MediBrick/IMU_Brick/v2/KiCAD/reports/mask-paste-audit-2026-09-21.md

# Activity Brick V2 mask and paste audit — 2026-09-21

This review compared the **saved PCB**, its placed footprints, and the project footprint library with the local manufacturer datasheets and integration manuals. The NCV8705 row was refreshed after its thermal holes were moved outside the footprint. It checks the CAD apertures, not a fabricated stencil. The assembler has not yet accepted the stencil adjustments.

| Device | Saved mask/paste construction | Review |
| --- | --- | --- |
| BMI323 U7 | All 14 pads have individual front-mask and front-paste apertures at the copper pad locations; no vias intersect the pads. | Consistent with the Bosch LGA land pattern in [BMI323](../../datasheets/BMI323.pdf). Confirm final stencil release and placement height with assembler. |
| BMM350 U5 | Nine 0.25 mm copper lands on 0.40 mm pitch; each mask opening is 0.30 mm from 0.025 mm radial expansion, leaving a nominal 0.10 mm mask web. Paste is 0.25 mm per land. No via intersects a land. | **NSMD confirmed**: mask opening is larger than copper. Bosch [BMM350](../../datasheets/BMM350.pdf) describes NSMD and points to its HSMI landing pattern. Fabricator/assembler must confirm that the 0.10 mm mask webs and nine small stencil apertures are achievable at yield. |
| BMP581 U6 | Ten individual copper, mask, and paste lands; no pad-intersecting vias. | The Bosch [BMP581](../../datasheets/bst_bmp581_ds004-2950309.pdf) soldering section requires at least 25 µm reflowed stand-off and warns against excess paste. The final stencil/process must be checked for that stand-off; the CAD alone cannot establish it. |
| TPS63802 U1 | Ten copper/mask lands. Pad 8 deliberately has **no pad-level paste**; two separate 0.55 × 0.25 mm front-paste shapes cover it. Other nine pads have paste. No pad-intersecting vias. | This matches the reduced pad-8, approximately 83% coverage example in the [TI TPS63802](../../datasheets/TPS63802.pdf) DLA0010A stencil drawing (PDF page 37, for a 0.10 mm stencil). The two paste shapes are present in both the library and saved PCB; a pad-only query would miss them. |
| NCV8705 U2 | Custom front-mask polygons expose the six perimeter pads and the solid 1.0 × 1.6 mm center pad 7. Six perimeter paste apertures are 0.46 × 0.31 mm; two center paste windows are 1.01 × 0.71 mm each. Pad 7 is now SMD copper only, with no holes. Two separate GND vias on the board at (166.40, 76.70) and (166.30, 79.85) mm lie outside the footprint's mask and paste openings. Each is 0.30 mm drill / 0.60 mm copper diameter. | **Via-in-pad issue resolved in CAD.** The external via rings are nominally 0.15 mm, and neither hole can wick solder from the exposed-pad paste windows. Confirm the final pad-7 GND copper connection and assembler's stencil acceptance. The [onsemi NCV8705](../../datasheets/NCV8705.pdf) package land pattern remains the package reference. |
| USBLC6-2SC6 D8 | Six individual SOT-23-6 copper/mask/paste lands; no pad-intersecting vias. | Conventional leaded SOT-23-6 apertures align with the [ST package drawing](../../datasheets/DS_usblc6-2.pdf). |
| MAX-M10S IC1 | Eighteen 0.7/0.8 × 1.8 mm copper lands use matching mask and full-size paste apertures; no pad-intersecting vias. | **Stencil adaptation remains open.** The [MAX-M10S integration manual](../../datasheets/MAX-M10S_IntegrationManual_UBX-20053088.pdf), §4.4.1, recommends a T-shaped paste pattern that shifts paste outward to wet the module's half-vias, and a 150 µm stencil. The current full-size rectangles do not implement that example. Its exact stencil is process-dependent; obtain assembler approval or revise the paste footprint before release. |
| ZED-F9P IC2 | All 54 perimeter pads and 48 central GND lands have individual copper/mask/paste apertures. Perimeter pads are 0.8 × 1.5 mm; central lands are 1.1 × 1.1 mm. No via intersects a land. | The [ZED-F9P integration manual](../../datasheets/ZED-F9P_IntegrationManual_UBX-18010802.pdf), §4.7.3, provides distinct copper and paste dimensions and says the final paste volume is process-dependent. The current 1:1 paste rectangles do not reproduce all suggested paste dimensions. Obtain assembler approval or tune the paste footprint; ensure all 48 central GND lands solder reliably without excess lift or voids. |

**Release status:** CAD aperture review complete. The NCV8705 via-in-pad concern is closed by the external-via layout. The checklist item remains open pending (1) fabricator/assembler acceptance of the BMM350 0.10 mm mask web and (2) approved MAX and ZED module stencil patterns and BMP581 stand-off. A physical stencil review, solder-paste inspection, and first-article inspection are appropriate for hidden NCV8705 and ZED joints.

## PCBWay capability comparison (checked 2026-09-21)

PCBWay's [standard capability table](https://www.pcbway.com/capabilities.html) lists 0.10 mm minimum trace/space, 0.15 mm minimum annular ring for a via pad, and a 4 mil (0.1016 mm) standard green solder-mask bridge for copper below 2 oz. The BMM350 custom rule is 0.15 mm trace width and 0.15 mm copper clearance; these copper features fit the published standard trace/space limits. Its 0.10 mm nominal mask web is just below the 4 mil bridge figure. Its 0.15 mm copper gap between adjacent 0.25 mm lands is also below the 0.20 mm IC pad spacing that PCBWay's [mask-bridge help](https://www.pcbway.com/helpcenter/soldermask_issues/Soldermask_bridge.html) says is needed to retain a green mask bridge. The [advanced table](https://www.pcbway.com/advanced-pcb-capabilities.html) lists a 3 mil minimum mask bridge, but does not by itself guarantee nine separate openings on this exact 0.40 mm BGA pitch. Request PCBWay's CAM acceptance of the actual Gerbers, explicitly requiring separate NSMD openings or an approved alternate; do not assume the Advanced PCB selector alone resolves it.

The revised NCV8705 layout uses ordinary GND vias outside the component footprint and solder apertures. Their 0.30 mm drills and 0.60 mm copper diameters give 0.15 mm nominal annular rings, matching PCBWay's published standard minimum. The two previous plated holes within pad 7 are absent from both the saved board footprint and the project library. No [PCBWay via-in-pad](https://www.pcbway.com/pcb_prototype/PCB_Via_in_Pad.html) fill/cap process is needed for these two external vias. This conclusion assumes the final GND copper connection survives zone refill and DRC, and does not replace first-article solder-joint inspection.

## Validation after the NCV8705 layout change

KiCad ERC on the saved schematic reports 0 active errors and 13 previously reviewed pin-type warnings. A later RF review removed the 0.0707 mm dangling `GNSS_RF_ZED` track at (129.55, 120.85) mm. KiCad DRC after that edit, with a temporary zone refill, reports **0 active violations, 0 unconnected pads and 0 footprint errors**. The all-severities DRC before the edit displayed the previously excluded C13 starved-thermal error; its exclusion has not been re-adjudicated. The NCV8705 external vias generate no active DRC violations. The temporary refill was not saved to the PCB; final fabrication-output review remains due.
