MediBrick/IMU_Brick/v2/KiCAD/reports/passive-rating-audit-2026-09-21.md

# Activity Brick V2 passive and voltage-rating audit — 2026-09-21

The selected ordering codes come from the Engineering BOM in `Activity_Brick_Production_BOM.xlsx`; the operating rails and component connections were checked against the saved PCB and `Activity Brick V2 Design.md`. MAX and ZED parts are mutually exclusive. This is a specification review, not a hot/cold operating test or short-circuit test.

## Capacitors and DC bias

| References and selected part | Maximum intended DC bias | Nominal / voltage / dielectric | Finding |
| --- | ---: | --- | --- |
| C1, Murata `GRM188R60J106ME47D` | `V_BAT` 4.2 V | 10 µF, 6.3 V, X5R, 0603 | Rated voltage passes. **Effective capacitance open:** TI [TPS63802](../../datasheets/TPS63802.pdf) §8.3 needs at least 4 µF effective at VIN; nominal 10 µF is insufficient proof after ±20% tolerance, DC bias, temperature and aging. C2 is an additional 1 µF on VIN but also derates. Obtain Murata part-specific C–DC-bias curves at 4.2 V and verify the combined minimum. |
| C4/C17, Murata `GRM188R61A226ME15D` | `3V8` ≈3.8 V | 2 × 22 µF, 10 V, X5R, 0603 | Rated voltage passes. TI specifies at least 7 µF **effective** on VOUT above 2.3 V and recommends 2 × 22 µF nominal above 3.6 V. The BOM uses that nominal arrangement, but part-specific capacitance at 3.8 V is not yet recorded. Verify combined minimum with tolerance/temperature/aging. |
| C18/C19, Murata `GRM188R61A106ME69D` | 3.3 / 3.8 V | 10 µF, 10 V, X5R, 0603 | Rated voltage passes. Verify effective capacitance for NCV8705 input/output transient behavior; nominal value alone is not a guaranteed value at bias. |
| C25, Murata `GRM155R61C225KE44D` | `V_BACKUP` 3.0 V | 2.2 µF, 16 V, X5R, 0402 | Rated voltage passes. A 2.2 µF nominal value in 0402 may lose substantial capacitance at 3 V; the BOM requirement states 2 µF. Verify the actual effective value against the ZED backup-supply requirement, or choose a larger-case qualified part. |
| C12, Samsung `CL21B225KOFNNNE` | BMM350 CRST domain, at most sensor core supply | 2.2 µF, 16 V, X7R, 0805 | The [Samsung exact-part page](https://product.samsungsem.com/mlcc/CL21B225KOFNNN.do) confirms the nominal specifications and offers a DC-bias graph, but no numerical minimum has been recorded. This is the accepted replacement for the obsolete Bosch-recommended TDK part. Samsung does **not** certify it as nonmagnetic; installed-board magnetic-offset validation remains necessary. |
| Other 0.1/1 µF Murata bypass capacitors | ≤3.8 V, except C21 on USB VBUS | 16 V, X5R/X7R, 0402 | Voltage rating passes. C21 on USB VBUS also has a 16 V rating; its effective 1 µF at the highest normal USB voltage should be checked against the AP2112 input-capacitor requirement. |

[Murata SimSurfing](https://ds.murata.com/simsurfing/mlcc.html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) provides part-specific C–DC-bias data. X5R/X7R is a temperature classification, not a DC-bias guarantee. Do not treat the nominal rating or a generic 50% derating rule as measured proof for these exact codes.

## Resistors and inductors

| Parts | Rating comparison | Finding |
| --- | --- | --- |
| MAX R40, Vishay `CRCW121010R0FKEAHP` | [Vishay CRCW-HP](https://www.vishay.com/docs/20115/crcwhp.pdf): 10 Ω, 0.75 W at 70 °C. At the MAX-M10S [absolute-maximum](../../datasheets/MAX-M10S.pdf) VCC_RF source current of 250 mA, `I²R = 0.625 W`; at the 50 mA operating allowance, 0.025 W. | Ordinary load is comfortable. The 250 mA number is an absolute-maximum stress rating, **not a guaranteed short-circuit current limit**. The formerly stated 1 W BOM engineering requirement is not met by this selected resistor. Keep the fault-case validation open; confirm short behavior or choose a higher-power geometry. |
| ZED R32, Bourns `CMP2010-FX-10R0ELF` | [Bourns CMP](../../datasheets/Bourns_CMP.pdf): 10 Ω, 1 W at 70 °C. At the ZED-F9P [absolute-maximum](../../datasheets/ZED-F9P.pdf) VCC_RF current of 300 mA, `I²R = 0.90 W`; at 50 mA, 0.025 W. | Meets its 1 W nominal requirement at ≤70 °C for a 300 mA case, subject to derating. A hypothetical ideal 3.3 V source shorted through 10 Ω would dissipate 1.09 W, so the real short-current/thermal behavior still needs validation. |
| Other populated 0402 resistors | BOM lists 0.063 W ratings. The 5.1 kΩ USB CC resistors dissipate about 5.4 mW each at 5.25 V; 100 kΩ pull resistors <0.2 mW at 4.2 V; 1 kΩ LED resistors <11 mW even with 3.3 V entirely across them. Low-value series resistors depend on signal/load current, not the full rail voltage. | No ordinary operating-power conflict identified. Verify manufacturer working-voltage and surge ratings if a specific resistor can see an external transient or fault. |
| L1, Coilcraft `XFL4015-471MEC` | [Coilcraft exact part](https://www.coilcraft.com/en-us/products/power/high-voltage-inductors/xfl/xfl4015/xfl4015-471/): 0.47 µH, 8.36 mΩ max DCR, 3.5 A at 10% inductance drop, 5.4 A at 20% drop, 9.1 A for 20 °C rise. TI lists this same inductor as a [TPS63802](../../datasheets/TPS63802.pdf) reference choice. | Pass for intended GNSS load. At 3.0 V minimum battery, 3.8 V output and 0.18 A output load, TI's boost equation gives roughly 0.5–0.6 A peak, well below its 10%-drop rating. Recalculate if the actual coincident load or minimum battery voltage changes. |
| MAX L2 `LQG15HN27NH02D`; ZED L3 `LQG15HS47NJ02D` | [Murata L2](https://www.murata.com/products/productdetail?partno=LQG15HN27NH02%23): 27 nH ±3%, 300 mA, 0.67 Ω max DCR. [Murata L3](https://www.murata.com/en-us/products/productdetail?partno=LQG15HS47NJ02D): 47 nH ±5%, 300 mA, 0.72 Ω max DCR. | Both pass the 50 mA normal active-antenna allowance. The 300 mA rating is only just equal to the ZED's absolute-maximum VCC_RF source current, so antenna-short survival is an electrical fault test, not a demonstrated continuous operating condition. |

## Maximum intended voltage and magnetometer materials

The stated battery range is 3.0–4.2 V. TPS63802 accepts 1.3–5.5 V, MCP1700 accepts 2.3–6.0 V, and NCV8705 sees regulated ≈3.8 V against a 5.5 V operating maximum; these ratings cover the intended battery and regulator rails. For ordinary USB 5 V operation, use **5.25 V** as the upper check point: [ST USBLC6-2](../../datasheets/DS_usblc6-2.pdf) specifies leakage at VBUS = 5.25 V and VBUS breakdown ≥6 V; [AP2112](../../datasheets/AP2112.pdf) allows VIN to 6.0 V in operation and has a 6.5 V absolute maximum. The USB-input C21 is 16 V. This does not validate arbitrary USB overvoltage, surge, or a noncompliant supply; the ESD device is not a sustained overvoltage disconnect.

The BMM350 vicinity contains C12, C13, C14 and nearby power/routing structures. C12's Samsung part is an already accepted **nonmagnetic-certification exception** in the design document. Neither this BOM nor the local datasheets certify the complete nearby assembly as nonmagnetic. The practical acceptance test is powered, assembled-board hard-/soft-iron calibration and comparison across the MAX and ZED population variants; retain this as a prototype validation requirement rather than claiming a material qualification.

**Checklist disposition:** Keep the combined passive-rating item open until exact-part DC-bias minima are recorded for C1/C2, C4/C17, C18/C19, C21 and C25, and the MAX/ZED antenna-short resistor and choke cases are validated or explicitly accepted with a justified fault duration/thermal limit. The selected inductor and ordinary voltage ratings pass the paper review; C12's magnetic-material exception requires installed-board validation.
