MediBrick/IMU_Brick/v2/KiCAD/reports/pin-pad-audit-2026-09-21.md

# Activity Brick V2 pin and pad audit — 2026-09-21

Scope: the saved schematic, saved PCB, and every project-local symbol and footprint used by them. Manufacturer pin tables and package/land-pattern drawings were compared directly; the 3D models were not used as pinout evidence. This is a CAD verification, not a physical assembly inspection.

The KiCad XML netlist was compared with PCB pad numbers for every used custom symbol. Every numbered schematic pin has a corresponding numbered PCB pad. All 17 used instances of project-local footprints have the same pad numbers, locations, sizes, and drills as their library masters. The manufacturer comparisons are below. `datasheets/` paths are relative to the project root.

| References / exact part | Manufacturer source | Pin, pad, and orientation result |
| --- | --- | --- |
| U7 BMI323 | [Bosch BMI323](../../datasheets/BMI323.pdf), pin configuration and package drawing | Pass. Pin 1 is SDO; pins 2, 3, 10, and 11 are NC. The footprint's pin-1 corner and all 14 numbered pads agree with the top-view drawing. NC pads have no schematic connection. |
| U5 BMM350 | [Bosch BMM350](../../datasheets/BMM350.pdf), pin table and top-view ball map | Pass. All A1–C3 functions agree. The footprint's A1 corner is identified on F.Fab. The CAD land array is rotated 90° relative to Bosch's illustrated top view; it is not mirrored. Use the A1 package mark, not the illustration's page orientation, for placement. |
| U6 BMP581 | [Bosch BMP581](../../datasheets/bst_bmp581_ds004-2950309.pdf), pin table and top-view package drawing | Pass. Pads 1–10 match; pads 3, 8, and 9 are VSS. The footprint axes are rotated relative to the datasheet view, without reflection. |
| IC1 MAX-M10S-00B | [u-blox MAX-M10S](../../datasheets/MAX-M10S.pdf), pin definition and footprint | Pass. Pin 1 is GND; RF_IN 11, VCC_RF 14, and SAFEBOOT_N 18 agree. The footprint pin-1 location matches the manufacturer's top view. |
| IC2 ZED-F9P-05B | [u-blox ZED-F9P](../../datasheets/ZED-F9P.pdf), pin definition and mechanical drawing | Pass for all numbered perimeter pins 1–54. Pin 1 and RF_IN 2 agree; VCC pins 33/34, V_USB 38, USB D− 39, and D+ 40 agree. Reserved pins are unconnected. The manufacturer's central 8×6 ground land array has no individual pin numbers; CAD numbers 55–102 are internal identifiers for those 48 GND pads, not manufacturer pin numbers. |
| U1 TPS63802DLAR | [TI TPS63802](../../datasheets/TPS63802.pdf), DLA0010A top-view pin table and package drawing | Pass. EN is 1, AGND 3, GND 8, VIN 10; all ten pads and pin-1 corner agree. |
| U2 NCV8705 | [onsemi NCV8705](../../datasheets/NCV8705.pdf), WDFN6 pin table and package drawing | Pass. OUT 1, NC 2/5, GND 3, EN 4, IN 6; exposed pad 7 is GND. Pad 7 is drawn as three copper shapes with the same electrical number, hence nine physical shapes but seven electrical pads. NC pins have no connection. |
| U4 AP2112K-3.3 | [Diodes Inc. AP2112](../../datasheets/AP2112.pdf), SOT25 pin table and package drawing | Pass. VIN 1, GND 2, EN 3, NC 4, VOUT 5. Pad 4 is unconnected. |
| U3, U8 MCP1700 | [Microchip MCP1700](../../datasheets/MCP1700.pdf), SOT-23 pin table and package drawing | Pass. GND 1, VOUT 2, VIN 3 on both placements. |
| D8 USBLC6-2SC6 | [ST USBLC6-2](../../datasheets/DS_usblc6-2.pdf), SOT23-6L top-view diagram | Pass. I/O1 1/6, GND 2, I/O2 3/4, VBUS 5. The connector and IC sides of each D line use the corresponding I/O pair. |
| J4 USB4120-03-C | [GCT USB4120 drawing](../../datasheets/USB4120_GCT_A3.pdf), recommended PCB layout and contact map | Pass. Vertical, top-mating receptacle. From the PCB top view, A1–A12 run left-to-right on one row; B12–B1 run left-to-right on the opposite row. A5/B5 are CC1/CC2; A6/B6 D+; A7/B7 D−; A8/B8 SBU1/SBU2 are intentionally unconnected. Four shield pads are grounded. Two unnumbered holes are mechanical locators, not missing symbol pins. |
| J2, J3 U.FL-R-SMT-1(10) | [Hirose U.FL manufacturer catalog](https://media.digikey.com/pdf/data%20sheets/hirose%20pdfs/ufl%20series.pdf), exact ordering code and receptacle PCB pattern | Pass. Top-mating connector; center signal pad 2 faces the RF trace, side grounds are pads 1 and 3. The same orientation is used for the separate MAX and ZED antenna connectors. |
| D2, D4 PESD0402-140 | [Littelfuse PESD catalog](../../datasheets/Littelfuse-Polymer-ESD-Suppressor-PESD-Catalog-Datasheet.pdf), package and land pattern | Pass. Two-terminal, nonpolar RF-to-GND ESD part; pads 1 and 2 correspond to the two physical terminals. |
| L1 XFL4015-471MEC | [Coilcraft XFL4015 drawing](https://www.coilcraft.com/getmedia/84927b8b-f089-421b-a7f4-a0fa23afe908/xfl4015.pdf) | Pass for two-terminal pad geometry and numbering. The coil has a start-lead indicator relevant to EMI optimization, but no electrical polarity. |

The populated LED choices are XINGLIGHT XL-1005UBC (D1/D7), XL-1005UYC (D3/D5), and XL-1005UGC (D6). Their [blue](https://www.xinglight.cn/uploadfile/202509/74e1407ba4890a4.pdf), [yellow](https://www.xinglight.cn/uploadfile/202506/529f892261aa8ba.pdf), and [green](https://www.xinglight.cn/uploadfile/202509/9bb79c5aba6539b.pdf) package/polarity drawings identify terminal 1 as cathode (−) and terminal 2 as anode (+). The PCB and schematic use that mapping on all five LEDs. Although the shared KiCad footprint name includes `Red`, the pad geometry and polarity match these selected parts.

No pin-number, polarity, mating-side, NC, or exposed-pad discrepancy was found in the saved CAD. The ZED central ground-pad numbering and NCV8705 split-pad representation are deliberate CAD conventions; they should be conveyed to assembly rather than interpreted as extra manufacturer pins. The separate solder-mask/paste and mechanical-fit checklist items remain open.
