MediBrick/IMU_Brick/v2/Activity_Brick_Production_BOM.xlsx

Sheet: README
Field | Content
Generated from | Activity_Brick.csv and KiCad XML netlist
Generated on | 2026-09-20
Workflow | Keep Activity_Brick.csv as the untouched KiCad export. Edit purchasing selections in this workbook.
Selection policy | Exact locked parts must not be substituted without engineering review. For commodity parts, prefer Yageo resistors and Murata capacitors with high current LCSC stock.
Stock policy | Enter LCSC number, stock quantity, and stock-check date immediately before ordering; inventory is time-sensitive.
Variant policy | MAX-M10S and ZED-F9P are mutually exclusive. ZED Production omits development USB; ZED Development populates it.
Validation | After manual LCSC selection, recheck package, tolerance, voltage/power/current, dielectric, DC-bias behavior, and approved alternates.
Source protection | Do not overwrite Activity_Brick.csv with this workbook. Regenerate and merge when KiCad changes.

Sheet: Engineering BOM
Variant | Option | Populate / DNP | References | Qty | Value | Description | KiCad Footprint | Manufacturer / Preference | Manufacturer Part Number | LCSC Part # | Mouser Part # | Tolerance | Voltage Rating | Power / Current Rating | Dielectric / Material | Minimum Engineering Requirements | Datasheet | Stock Check Date | Stock at Check | Approved Alternate | Notes
Common | Assembly configuration | PCB feature | JP1 | 1 | I2C pull up | Solder Jumper, 3-pole, open | Jumper_3_NO | DNP |  | DNP |  |  |  |  |  |  |  |  |  |  | Assembly default: all three contacts open; no common I2C pull-up selected.
Common | Assembly configuration | PCB feature | JP3 | 1 | LED ON | Jumper, 2-pole, open | Jumper_2_NO_NoSilk | DNP |  | DNP |  |  |  |  |  |  |  |  |  |  | Assembly default: leave open; common D1 LED fitted but disabled.
Common | Assembly configuration | PCB feature | TP1, TP2 | 2 | GNSS 3V3, V_BACKUP | Test Point | TestPoint-1.0mm | DNP |  | DNP |  |  |  |  |  |  |  |  |  |  | Bare PCB test pads; no components or assembly operation.
Common | Mechanical | No purchase | H1, H2, H3, H4 | 4 | Mounting Hole | Mounting Hole without connection | MountingHole_3.5mm | DNP |  | DNP
Common | Standard | Populate | C1 | 1 | 10uF | Unpolarized capacitor, X5R/X7R | C_0603_1608Metric | Murata | GRM188R60J106ME47D | C77041 (https://www.lcsc.com/product-detail/C77041.html) |  | 20% | 6.3V |  | X5R | 10uF; 6.3V; 20%; verify DC-bias derating |  | 2026-09-20 | 204650
Common | Standard | Populate | C2, C3, C22, C23 | 4 | 1.0uF | Unpolarized capacitor | C_0402_1005Metric | Murata | GRM155R61C105KE01D | C77007 (https://www.lcsc.com/product-detail/C77007.html) |  | 10% | 16V |  | X5R | 1.0uF; 16V; 10%; verify DC-bias derating |  | 2026-09-20 | 279200
Common | Standard | Populate | C4 | 1 | 22uF | Unpolarized capacitor, X5R | C_0603_1608Metric | Murata | GRM188R61A226ME15D | C84419 (https://www.lcsc.com/product-detail/C84419.html) |  | 20% | 10V |  | X5R | 22uF; 10V; 20%; verify DC-bias derating |  | 2026-09-20 | 516685
Common | Standard | Populate | C8, C9, C10, C11, C13, C14 | 6 | 0.1uF | Unpolarized capacitor | C_0402_1005Metric | Murata | GRM155R71C104KA88D | C71629 (https://www.lcsc.com/product-detail/C71629.html) |  | 10% | 16V |  | X7R | 0.1uF; 16V; 10%; verify DC-bias derating |  | 2026-09-20 | 2302200
Common | Standard | Populate | C12 | 1 | 2.2uF | BMM350 CRST capacitor, 2.2 uF, low ESR/ESL, nonmagnetic required | C_0805_2012Metric | Samsung | CL21B225KOFNNNE | C28234 (https://www.lcsc.com/product-detail/C28234.html) |  | 10% | 16V |  | X7R | 2.2 uF; >=6.3 V; 10%; X7R; low ESR/ESL; nonmagnetic; 0805; place at BMM350 CRST |  | 2026-09-20 | 79940 | Engineering exception accepted: Samsung CL21B225KOFNNNE | SELECTED: Samsung CL21B225KOFNNNE matches 2.2 uF, 10%, X7R, 16 V and 0805 and was in stock. It replaces the obsolete Bosch-recommended TDK part. Samsung does not specify nonmagnetic construction; validate installed-board BMM350 magnetic offsets.
Common | Standard | Populate | C17 | 1 | 22uF | Unpolarized capacitor, X5R/X7R | C_0603_1608Metric | Murata | GRM188R61A226ME15D | C84419 (https://www.lcsc.com/product-detail/C84419.html) |  | 20% | 10V |  | X5R | 22uF; 10V; 20%; verify DC-bias derating |  | 2026-09-20 | 516685
Common | Standard | Populate | C18, C19 | 2 | 10uF | Unpolarized capacitor, X5R | C_0603_1608Metric | Murata | GRM188R61A106ME69D | C90053 (https://www.lcsc.com/product-detail/C90053.html) |  | 20% | 10V |  | X5R | 10uF; 10V; 20%; verify DC-bias derating |  | 2026-09-20 | 114880
Common | Standard | Populate | D1 | 1 | Blue | Light emitting diode | LED_0402_1005Metric_Blue | XINGLIGHT | XL-1005UBC | C22355736 (https://www.lcsc.com/product-detail/C22355736.html) |  |  |  |  |  |  |  | 2026-09-20 | 267000
Common | Standard | DNP | J1 | 1 | Conn_01x18_Pin | Generic connector, single row, 01x18, script generated | PinHeader_1x18_P2.54mm_Vertical | DNP | DNP | DNP |  |  |  |  |  |  |  |  |  |  | DNP by design: retain the 1x18 plated through-holes on the PCB for optional access; do not install or purchase a pin header.
Common | Standard | Populate | L1 | 1 | XFL4015-471MEC | Inductor | IND_XFL4015_COC | Coilcraft | XFL4015-471MEC | C18221164 (https://www.lcsc.com/product-detail/C18221164.html) |  |  |  |  |  | 0.47 uH shielded power inductor; saturation current and DCR suitable for TPS63802 |  | 2026-09-20 | 4067
Common | Standard | Populate | R1, R2 | 2 | 100k | Resistor | R_0402_1005Metric | Yageo | RC0402FR-07100KL | C60491 (https://www.lcsc.com/product-detail/C60491.html) |  | 1% |  | 0.063 W |  | 100k; 0402 unless footprint states otherwise; verify tolerance and power |  | 2026-09-20 | 8343600
Common | Standard | Populate | R3, R4 | 2 | 10 | Resistor | R_0402_1005Metric | Yageo | RC0402FR-0710RL | C138066 (https://www.lcsc.com/product-detail/C138066.html) |  | 1% |  | 0.063 W |  | 10; 0402 unless footprint states otherwise; verify tolerance and power |  | 2026-09-20 | 1512400
Common | Standard | Populate | R5 | 1 | 604k | Resistor | R_0402_1005Metric | Vishay | CRCW0402604KFKED | C2085221 (https://www.lcsc.com/product-detail/C2085221.html) |  | 1% |  | 0.063 W |  | 604k; 0402 unless footprint states otherwise; verify tolerance and power |  | 2026-09-20 | 400
Common | Standard | Populate | R6 | 1 | 91k | Resistor | R_0402_1005Metric | Yageo | AC0402FR-0791KL | C144733 (https://www.lcsc.com/product-detail/C144733.html) |  | 1% |  | 0.063 W |  | 91k; 0402 unless footprint states otherwise; verify tolerance and power |  | 2026-09-20 | 44500
Common | Standard | Populate | R15, R17 | 2 | 2.2k | Resistor | R_0402_1005Metric | Yageo | RC0402FR-072K2L | C114762 (https://www.lcsc.com/product-detail/C114762.html) |  | 1% |  | 0.063 W |  | 2.2k; 0402 unless footprint states otherwise; verify tolerance and power |  | 2026-09-20 | 1356300
Common | Standard | Populate | R16 | 1 | 1k | Resistor | R_0402_1005Metric | Yageo | RC0402FR-071KL | C106235 (https://www.lcsc.com/product-detail/C106235.html) |  | 1% |  | 0.063 W |  | 1k; 0402 unless footprint states otherwise; verify tolerance and power |  | 2026-09-20 | 2630200
Common | Standard | Populate | U1 | 1 | TPS63802DLAR | Buck-Boost | DLA0010A | Texas Instruments | TPS63802DLAR | C2845237 (https://www.lcsc.com/product-detail/C2845237.html) |  |  |  |  |  | Exact manufacturer ordering code and verified footprint | https://www.ti.com/lit/gpn/tps63802 | 2026-09-20 | 6650
Common | Standard | Populate | U2 | 1 | NCV8705MT33TCG | 500 mA ultra-low-noise 3.3 V LDO, WDFN6, onsemi | WDFN6_2X2_ONS_NCV8705 | onsemi | NCV8705MT33TCG | C604084 (https://www.lcsc.com/product-detail/C604084.html) |  |  |  |  |  | Exact manufacturer ordering code and verified footprint | ${KIPRJMOD}/../datasheets/NCV8705.pdf | 2026-09-20 | 4476
Common | Standard | Populate | U3 | 1 | MCP1700T-3002E_TT | MCP1700T-3002E/TT,LDOVoltage Regulator,250mA,3V +/-2%,2.3 to 6Vin,3-Pin SOT-23 | Microchip Technology Inc. MCP1700T-3002E/TT | SOT95P237X112-3N_MCP1700 | Microchip Technology | MCP1700T-3002E/TT | C62244 (https://www.lcsc.com/product-detail/C62244.html) |  |  |  |  |  | Exact manufacturer ordering code and verified footprint |  | 2026-09-20 | 2870
Common | Standard | Populate | U5 | 1 | BMM350 | Magnetomoer | BGA9_BMM350_BOS | Bosch Sensortec | BMM350 | C17225907 (https://www.lcsc.com/product-detail/C17225907.html) |  |  |  |  |  | Exact manufacturer ordering code and verified footprint |  | 2026-09-20 | 2789
Common | Standard | Populate | U6 | 1 | BMP581 | Barometer | QFN10_BMP581_BOS | Bosch Sensortec | BMP581 | C5362283 (https://www.lcsc.com/product-detail/C5362283.html) |  |  |  |  |  | Exact manufacturer ordering code and verified footprint |  | 2026-09-20 | 4000
Common | Standard | Populate | U7 | 1 | BMI323 | IMU | BMI323_BOS | Bosch Sensortec | BMI323 | C5368700 (https://www.lcsc.com/product-detail/C5368700.html) |  |  |  |  |  | Exact manufacturer ordering code and verified footprint |  | 2026-09-20 | 3524
Common | Standard | Populate | U8 | 1 | MCP1700T-1802E/TT | LDO Regulator | SOT95P237X112-3N_MCP1700_1802 | Microchip Technology | MCP1700T-1802E/TT | C150796 (https://www.lcsc.com/product-detail/C150796.html) |  |  |  |  |  | Exact manufacturer ordering code and verified footprint |  | 2026-09-20 | 3779
MAX-M10S | Assembly configuration | PCB feature | JP2 | 1 | MAX PPS | Solder Jumper, 2-pole, closed/bridged | Jumper_2_NC_Trace | DNP |  | DNP |  |  |  |  |  |  |  |  |  |  | MAX assembly default: leave normally-closed copper trace intact; D3 indicator return enabled.
MAX-M10S | Assembly configuration | PCB feature | JP4 | 1 | MAX Enable Bias | Solder Jumper, 2-pole, open: disabled bias, closed: 3V bias enabled | Jumper_2_NO | DNP |  | DNP |  |  |  |  |  |  |  |  |  |  | MAX assembly default: leave open for passive antenna. Bridge only for a separately reviewed active-antenna build.
MAX-M10S | Assembly configuration | PCB feature | JP5, JP6 | 2 | MAX Enable I2C | Solder Jumper, 2-pole, open: disabled bias, closed: 3V bias enabled | Jumper_2_NO | DNP |  | DNP |  |  |  |  |  |  |  |  |  |  | MAX assembly default: leave both open; UART interface used.
MAX-M10S | Assembly configuration | PCB feature | TP3, TP4, TP5 | 3 | MAX INT, PPS, SAFE | Test Point | TestPoint-1.0mm | DNP |  | DNP |  |  |  |  |  |  |  |  |  |  | Bare PCB test pads for MAX option; no components or assembly operation.
MAX-M10S | Standard | Populate | C5, C6, C15 | 3 | 0.1uF | Unpolarized capacitor | C_0402_1005Metric | Murata | GRM155R71C104KA88D | C71629 (https://www.lcsc.com/product-detail/C71629.html) |  | 10% | 16V |  | X7R | 0.1uF; 16V; 10%; verify DC-bias derating |  | 2026-09-20 | 2302200
MAX-M10S | Standard | Populate | C7 | 1 | 1.0uF | Unpolarized capacitor | C_0402_1005Metric | Murata | GRM155R61C105KE01D | C77007 (https://www.lcsc.com/product-detail/C77007.html) |  | 10% | 16V |  | X5R | 1.0uF; 16V; 10%; verify DC-bias derating |  | 2026-09-20 | 279200
MAX-M10S | Standard | Populate | C16 | 1 | 10nF X7R | Unpolarized capacitor | C_0402_1005Metric | Murata | GRM155R71C103KA01J | C3011655 (https://www.lcsc.com/product-detail/C3011655.html) |  | 10% | 16V |  | X7R | Use exact documented part unless engineering review approves a replacement |  | 2026-09-20 | 9900
MAX-M10S | Standard | Populate | D2 | 1 | PESD0402-140 | 40V Clamp - Ipp Tvs Diode | DIO_PESD0402-140 | Littelfuse | PESD0402-140 | C10662 (https://www.lcsc.com/product-detail/C10662.html) |  |  |  |  |  | Exact manufacturer ordering code and verified footprint |  | 2026-09-20 | 73695
MAX-M10S | Standard | Populate | D3 | 1 | Yellow | Light emitting diode | LED_0402_1005Metric | XINGLIGHT | XL-1005UYC | C25503856 (https://www.lcsc.com/product-detail/C25503856.html) |  |  |  |  |  |  |  | 2026-09-20 | 77500
MAX-M10S | Standard | Populate | IC1 | 1 | MAX-M10S-00B | GPS Modules u-blox M10 GNSS LCC module, firmware in ROM, SAW filter, LNA | MAXM10S00B | u-blox | MAX-M10S-00B | C4153167 (https://www.lcsc.com/product-detail/C4153167.html) |  |  |  |  |  | Exact manufacturer ordering code and verified footprint | https://content.u-blox.com/sites/default/files/MAX-M10S_IntegrationManual_UBX-20053088.pdf | 2026-09-20 | 763 |  | Mutually exclusive GNSS assembly option
MAX-M10S | Standard | Populate | J2 | 1 | U.FL-R-SMT-1_10_ | U.FL (UMCC) Connector Receptacle, Male Pin 50 Ohms Surface Mount Solder | HRS_U.FL-R-SMT-1_10_ | Hirose | U.FL-R-SMT-1(10) | C88373 (https://www.lcsc.com/product-detail/C88373.html) |  |  |  |  |  | Exact manufacturer ordering code and verified footprint |  | 2026-09-20 | 8975
MAX-M10S | Standard | Populate | L2 | 1 | 27nH | Inductor, Murata LQG15H, LQW15A Series 27nH 5% | L_0402_1005Metric | Murata | LQG15HN27NH02D | C1331771 (https://www.lcsc.com/product-detail/C1331771.html) |  |  |  |  |  | 27 nH, 3%, >=300 mA, 0402 RF choke; exact selected part |  | 2026-09-20 | 4800
MAX-M10S | Standard | Populate | R7, R8, R9, R10, R11, R13, R14 | 7 | 33 | Resistor | R_0402_1005Metric | Yageo | RC0402FR-0733RL | C138002 (https://www.lcsc.com/product-detail/C138002.html) |  | 1% |  | 0.063 W |  | 33; 0402 unless footprint states otherwise; verify tolerance and power |  | 2026-09-20 | 8094900
MAX-M10S | Standard | DNP | R12 | 1 | DNP (33) | Resistor | R_0402_1005Metric | Yageo | RC0402FR-0733RL | C138002 (https://www.lcsc.com/product-detail/C138002.html) |  | 1% |  | 0.063 W |  | DNP (33); 0402 unless footprint states otherwise; verify tolerance and power |  | 2026-09-20 | 8094900 |  | DNP by default; controlled recovery access only
MAX-M10S | Standard | Populate | R18 | 1 | 1k | Resistor | R_0402_1005Metric | Yageo | RC0402FR-071KL | C106235 (https://www.lcsc.com/product-detail/C106235.html) |  | 1% |  | 0.063 W |  | 1k; 0402 unless footprint states otherwise; verify tolerance and power |  | 2026-09-20 | 2630200
MAX-M10S | Standard | Populate | R40 | 1 | 10 | Resistor | R_1210_3225Metric | Vishay | CRCW121010R0FKEAHP | C844442 (https://www.lcsc.com/product-detail/C844442.html) |  | 1% |  | 0.75 W at 70 degC | Thick film | 10 ohm; 1%; 1 W; 1210; withstand active-antenna short-circuit current |  | 2026-09-21 | 8610 | No 1 W 1210 LCSC substitute approved | LCSC-SOURCED, FAULT CASE OPEN: Vishay CRCW121010R0FKEAHP is 10 ohm, 1%, 0.75 W, 1210 and was in stock at check. MAX-M10S 250 mA is an absolute-maximum source-current rating, not a guaranteed clamp. A hard short at 3.3 V across 10 ohm would dissipate 1.09 W (1.30 W at 3.6 V) if supply remains up. Verify actual short-current limiting or add fault protection before approving sustained-short operation.
ZED-F9P | Assembly configuration | PCB feature | JP7, JP9, JP10 | 3 | ZED PPS, RTK, GEOFENCE | Solder Jumper, 2-pole, closed/bridged | Jumper_2_NC_Trace | DNP |  | DNP |  |  |  |  |  |  |  |  |  |  | ZED assembly default: leave all three normally-closed indicator-return traces intact.
ZED-F9P | Assembly configuration | PCB feature | JP8 | 1 | DZED _SEL | Open selects UART & I2C, Close select SPI | Jumper_2_NO | DNP |  | DNP |  |  |  |  |  |  |  |  |  |  | ZED assembly default: leave open for UART/I2C mode, not SPI.
ZED-F9P | Assembly configuration | PCB feature | JP11 | 1 | ZED Enable Bias | Normally closed antenna-bias disconnect jumper | Jumper_2_NC_Trace | DNP |  | DNP |  |  |  |  |  |  |  |  |  |  | ZED assembly default: leave normally-closed antenna-bias trace intact.
ZED-F9P | Assembly configuration | PCB feature | JP12, JP13 | 2 | ZED Enable I2C | Solder Jumper, 2-pole, open: disabled bias, closed: 3V bias enabled | Jumper_2_NO | DNP |  | DNP |  |  |  |  |  |  |  |  |  |  | ZED assembly default: leave both open; UART interface used.
ZED-F9P | Assembly configuration | PCB feature | JP14 | 1 | USB omitted: ground V_USB | Close only when USB option is omitted; mutually exclusive with U4 output | Jumper_2_NO | DNP |  | DNP |  |  |  |  |  |  |  |  |  |  | ZED Production: bridge closed to ground V_USB because USB parts are DNP. ZED Development: leave open with U4 populated. Never close with USB LDO active.
ZED-F9P | Assembly configuration | PCB feature | TP6, TP7, TP8 | 3 | ZED INT, PPS, SAFE | Test Point | TestPoint-1.0mm | DNP |  | DNP |  |  |  |  |  |  |  |  |  |  | Bare PCB test pads for ZED option; no components or assembly operation.
ZED-F9P | Development USB | Development only | C21, C24 | 2 | 1.0uF | Unpolarized capacitor | C_0402_1005Metric | Murata | GRM155R61C105KE01D | C77007 (https://www.lcsc.com/product-detail/C77007.html) |  | 10% | 16V |  | X5R | 1.0uF; 16V; 10%; verify DC-bias derating |  | 2026-09-20 | 279200 |  | Populate only for ZED development USB build; DNP in final product
ZED-F9P | Development USB | Development only | C28 | 1 | 1.0uF | Unpolarized capacitor | C_0402_1005Metric | Murata | GRM155R61C105KE01D | C77007 (https://www.lcsc.com/product-detail/C77007.html) |  | 10% | 16V |  | X5R | 1.0uF; 16V; 10%; verify DC-bias derating |  | 2026-09-20 | 279200 |  | Populate only for ZED development USB build; DNP in final product
ZED-F9P | Development USB | Development only | D8 | 1 | USBLC6-2SC6 | 17V Clamp 5A (8/20µs) Ipp Tvs Diode | USBLC6-2SC6_SOT23-6L | STMicroelectronics | USBLC6-2SC6 | C7519 (https://www.lcsc.com/product-detail/C7519.html) |  |  |  |  |  | Exact manufacturer ordering code and verified footprint | https://www.st.com/resource/en/datasheet/usblc6-2.pdf | 2026-09-20 | 21165 |  | Populate only for ZED development USB build; DNP in final product
ZED-F9P | Development USB | Development only | J4 | 1 | USB4120-03-C | USB C receptacle | USB4120-03-C_GCT | GCT | USB4120-03-C | C3445864 (https://www.lcsc.com/product-detail/C3445864.html) |  |  |  |  |  | Exact manufacturer ordering code and verified footprint | https://gct.co/connector/usb4120 | 2026-09-20 | 557 |  | Populate only for ZED development USB build; DNP in final product
ZED-F9P | Development USB | Development only | R34, R35 | 2 | 5.1k | Resistor | R_0402_1005Metric | Yageo | RC0402FR-075K1L | C105872 (https://www.lcsc.com/product-detail/C105872.html) |  | 1% |  | 0.063 W |  | 5.1k; 0402 unless footprint states otherwise; verify tolerance and power |  | 2026-09-20 | 2165200 |  | Populate only for ZED development USB build; DNP in final product
ZED-F9P | Development USB | Development only | R38, R39 | 2 | 27 | Resistor | R_0402_1005Metric | Yageo | RC0402FR-0727RL | C138021 (https://www.lcsc.com/product-detail/C138021.html) |  | 1% |  | 0.063 W |  | 27; 0402 unless footprint states otherwise; verify tolerance and power |  | 2026-09-20 | 35300 |  | Populate only for ZED development USB build; DNP in final product
ZED-F9P | Development USB | Development only | R41 | 1 | 100k | Resistor | R_0402_1005Metric | Yageo | RC0402FR-07100KL | C60491 (https://www.lcsc.com/product-detail/C60491.html) |  | 1% |  | 0.063 W |  | 100k; 0402 unless footprint states otherwise; verify tolerance and power |  | 2026-09-20 | 8343600 |  | Populate only for ZED development USB build; DNP in final product
ZED-F9P | Development USB | Development only | U4 | 1 | AP2112K-3.3TRG1 | LDO Regulator | SOT_RG1_DIO_AP2112K | Diodes Incorporated | AP2112K-3.3TRG1 | C51118 (https://www.lcsc.com/product-detail/C51118.html) |  |  |  |  |  | Exact manufacturer ordering code and verified footprint | ${KIPRJMOD}/../datasheets/AP2112.pdf | 2026-09-20 | 52940 |  | Populate only for ZED development USB build; DNP in final product
ZED-F9P | Standard | Populate | C20 | 1 | 100nF | Murata GRM155R71C104JA88D, 100 nF, 5%, 16 V, X7R, 0402 | C_0402_1005Metric | Murata | GRM155R71C104JA88D | C913742 (https://www.lcsc.com/product-detail/C913742.html) |  | 5% | 16V |  | X7R | Use exact documented part unless engineering review approves a replacement |  | 2026-09-20 | 17050
ZED-F9P | Standard | Populate | C25 | 1 | 2.2uF | Unpolarized capacitor | C_0402_1005Metric | Murata | GRM155R61C225KE44D | C335109 (https://www.lcsc.com/product-detail/C335109.html) |  | 10% | 16V |  | X5R | 2uF; 16V; 10%; verify DC-bias derating |  | 2026-09-20 | 24100
ZED-F9P | Standard | Populate | C26 | 1 | 0.1uF | Unpolarized capacitor | C_0402_1005Metric | Murata | GRM155R71C104KA88D | C71629 (https://www.lcsc.com/product-detail/C71629.html) |  | 10% | 16V |  | X7R | 0.1uF; 16V; 10%; verify DC-bias derating |  | 2026-09-20 | 2302200
ZED-F9P | Standard | Populate | C27 | 1 | 1.0uF | Unpolarized capacitor | C_0402_1005Metric | Murata | GRM155R61C105KE01D | C77007 (https://www.lcsc.com/product-detail/C77007.html) |  | 10% | 16V |  | X5R | 1.0uF; 16V; 10%; verify DC-bias derating |  | 2026-09-20 | 279200
ZED-F9P | Standard | Populate | D4 | 1 | PESD0402-140 | 40V Clamp - Ipp Tvs Diode | DIO_PESD0402-140 | Littelfuse | PESD0402-140 | C10662 (https://www.lcsc.com/product-detail/C10662.html) |  |  |  |  |  | Exact manufacturer ordering code and verified footprint |  | 2026-09-20 | 73695
ZED-F9P | Standard | Populate | D5 | 1 | Yellow | Light emitting diode | LED_0402_1005Metric_Red | XINGLIGHT | XL-1005UYC | C25503856 (https://www.lcsc.com/product-detail/C25503856.html) |  |  |  |  |  |  |  | 2026-09-20 | 77500
ZED-F9P | Standard | Populate | D6 | 1 | GREEN | Light emitting diode | LED_0402_1005Metric_Red | XINGLIGHT | XL-1005UGC | C965793 (https://www.lcsc.com/product-detail/C965793.html) |  |  |  |  |  |  |  | 2026-09-20 | 1209750
ZED-F9P | Standard | Populate | D7 | 1 | BLUE | Light emitting diode | LED_0402_1005Metric_Red | XINGLIGHT | XL-1005UBC | C22355736 (https://www.lcsc.com/product-detail/C22355736.html) |  |  |  |  |  |  |  | 2026-09-20 | 267000
ZED-F9P | Standard | Populate | IC2 | 1 | ZED-F9P-05B | GNSS / GPS Modules High Precision Multi-band RTK GNSS module, with Galileo OSNMA | ZEDF9P05B | u-blox | ZED-F9P-05B |  | 134-ZED-F9P-05B (https://mou.sr/4hiiybo) |  |  |  |  | Exact manufacturer ordering code and verified footprint | https://www.u-blox.com/en/product/zed-f9p-module | 2026-09-21 | 791 | ZED-F9P-04B / LCSC C5120257 only after hardware, firmware, and feature revision review | APPROVED MOUSER SOURCE: 134-ZED-F9P-05B matches exact u-blox ZED-F9P-05B. LCSC C5120257 is -04B and is not approved as a substitute.
ZED-F9P | Standard | Populate | J3 | 1 | U.FL-R-SMT-1_10_ | U.FL (UMCC) Connector Receptacle, Male Pin 50 Ohms Surface Mount Solder | HRS_U.FL-R-SMT-1_10_ | Hirose | U.FL-R-SMT-1(10) | C88373 (https://www.lcsc.com/product-detail/C88373.html) |  |  |  |  |  | Exact manufacturer ordering code and verified footprint |  | 2026-09-20 | 8975
ZED-F9P | Standard | Populate | L3 | 1 | 47nH | Inductor, Murata LQG15H, LQW15A Series 47nH 5% | L_0402_1005Metric | Murata | LQG15HS47NJ02D | C97998 (https://www.lcsc.com/product-detail/C97998.html) |  |  |  |  |  | 47 nH, 5%, >=300 mA, >500 ohm impedance from 1-1.8 GHz, 0402; exact selected part |  | 2026-09-20 | 56050
ZED-F9P | Standard | Populate | R20, R22, R23, R24, R25, R26, R27, R31, R33, R36, R37 | 11 | 33 | Resistor | R_0402_1005Metric | Yageo | RC0402FR-0733RL | C138002 (https://www.lcsc.com/product-detail/C138002.html) |  | 1% |  | 0.063 W |  | 33; 0402 unless footprint states otherwise; verify tolerance and power |  | 2026-09-20 | 8094900
ZED-F9P | Standard | Populate | R21, R29, R30 | 3 | 1k | Resistor | R_0402_1005Metric | Yageo | RC0402FR-071KL | C106235 (https://www.lcsc.com/product-detail/C106235.html) |  | 1% |  | 0.063 W |  | 1k; 0402 unless footprint states otherwise; verify tolerance and power |  | 2026-09-20 | 2630200
ZED-F9P | Standard | DNP | R28 | 1 | 33 DNP | Resistor | R_0402_1005Metric | Yageo | RC0402FR-0733RL | C138002 (https://www.lcsc.com/product-detail/C138002.html) |  | 1% |  | 0.063 W |  | 33 DNP; 0402 unless footprint states otherwise; verify tolerance and power |  | 2026-09-20 | 8094900 |  | DNP by default; controlled recovery access only
ZED-F9P | Standard | Populate | R32 | 1 | 10 | Resistor | R_2010_5025Metric | Bourns | CMP2010-FX-10R0ELF | C1880468 (https://www.lcsc.com/product-detail/C1880468.html) |  | 1% | 200 V | 1 W at ambient <=70 degC; derate above 70 degC | Thick film, high-power anti-surge | 10 ohm; 1%; >=1 W; 2010; withstand active-antenna short-circuit current | ${KIPRJMOD}/../datasheets/Bourns_CMP.pdf | 2026-09-20 | 1595 |  | Approved and implemented selection for the ZED-F9P antenna-bias current limiter. LCSC identity, 10 ohm, 1%, 1 W, 2010 package, and availability verified 2026-09-20. The saved schematic and PCB use R_2010_5025Metric; placement and routing are complete, with zero unconnected items in the post-layout DRC.

Sheet: MAX Production
Variant | Option | Populate / DNP | References | Qty | Value | Description | KiCad Footprint | Manufacturer / Preference | Manufacturer Part Number | LCSC Part # | Tolerance | Voltage Rating | Power / Current Rating | Dielectric / Material | Minimum Engineering Requirements | Datasheet | Stock Check Date | Stock at Check | Approved Alternate | Notes | Approved supplier part #
Common | Assembly configuration | PCB feature | JP1 | 1 | I2C pull up | Solder Jumper, 3-pole, open | Jumper_3_NO | DNP |  | DNP |  |  |  |  |  |  |  |  |  | Assembly default: all three contacts open; no common I2C pull-up selected.
Common | Assembly configuration | PCB feature | JP3 | 1 | LED ON | Jumper, 2-pole, open | Jumper_2_NO_NoSilk | DNP |  | DNP |  |  |  |  |  |  |  |  |  | Assembly default: leave open; common D1 LED fitted but disabled.
Common | Assembly configuration | PCB feature | TP1, TP2 | 2 | GNSS 3V3, V_BACKUP | Test Point | TestPoint-1.0mm | DNP |  | DNP |  |  |  |  |  |  |  |  |  | Bare PCB test pads; no components or assembly operation.
Common | Graphic | No purchase | G1 | 1 | Creative Commons logo | Padless Creative Commons PCB graphic | PCM_SparkFun-Aesthetic:Creative_Commons_License |  |  |  |  |  |  |  | No purchased component |  |  |  |  | Padless Creative Commons graphic on saved PCB; no purchased part.
Common | Graphic | No purchase | G*** | 1 | OSHW logo | Padless OSHW silkscreen graphic | OSHW-logo_silkscreen-back_4mm |  |  |  |  |  |  |  | No purchased component |  |  |  |  | Padless OSHW logo graphic on saved PCB; no purchased part.
Common | Mechanical | No purchase | H1, H2, H3, H4 | 4 | Mounting Hole | Mounting Hole without connection | MountingHole_3.5mm | DNP |  | DNP
Common | Standard | Populate | C1 | 1 | 10uF | Unpolarized capacitor, X5R/X7R | C_0603_1608Metric | Murata | GRM188R60J106ME47D | C77041 (https://www.lcsc.com/product-detail/C77041.html) | 20% | 6.3V |  | X5R | 10uF; 6.3V; 20%; verify DC-bias derating |  | 2026-09-20 | 204650
Common | Standard | Populate | C2, C3, C22, C23 | 4 | 1.0uF | Unpolarized capacitor | C_0402_1005Metric | Murata | GRM155R61C105KE01D | C77007 (https://www.lcsc.com/product-detail/C77007.html) | 10% | 16V |  | X5R | 1.0uF; 16V; 10%; verify DC-bias derating |  | 2026-09-20 | 279200
Common | Standard | Populate | C4 | 1 | 22uF | Unpolarized capacitor, X5R | C_0603_1608Metric | Murata | GRM188R61A226ME15D | C84419 (https://www.lcsc.com/product-detail/C84419.html) | 20% | 10V |  | X5R | 22uF; 10V; 20%; verify DC-bias derating |  | 2026-09-20 | 516685
Common | Standard | Populate | C8, C9, C10, C11, C13, C14 | 6 | 0.1uF | Unpolarized capacitor | C_0402_1005Metric | Murata | GRM155R71C104KA88D | C71629 (https://www.lcsc.com/product-detail/C71629.html) | 10% | 16V |  | X7R | 0.1uF; 16V; 10%; verify DC-bias derating |  | 2026-09-20 | 2302200
Common | Standard | Populate | C12 | 1 | 2.2uF | BMM350 CRST capacitor, 2.2 uF, low ESR/ESL, nonmagnetic required | C_0805_2012Metric | Samsung | CL21B225KOFNNNE | C28234 (https://www.lcsc.com/product-detail/C28234.html) | 10% | 16V |  | X7R | 2.2 uF; >=6.3 V; 10%; X7R; low ESR/ESL; nonmagnetic; 0805; place at BMM350 CRST |  | 2026-09-20 | 79940 | Engineering exception accepted: Samsung CL21B225KOFNNNE | SELECTED: Samsung CL21B225KOFNNNE matches 2.2 uF, 10%, X7R, 16 V and 0805 and was in stock. It replaces the obsolete Bosch-recommended TDK part. Samsung does not specify nonmagnetic construction; validate installed-board BMM350 magnetic offsets.
Common | Standard | Populate | C17 | 1 | 22uF | Unpolarized capacitor, X5R/X7R | C_0603_1608Metric | Murata | GRM188R61A226ME15D | C84419 (https://www.lcsc.com/product-detail/C84419.html) | 20% | 10V |  | X5R | 22uF; 10V; 20%; verify DC-bias derating |  | 2026-09-20 | 516685
Common | Standard | Populate | C18, C19 | 2 | 10uF | Unpolarized capacitor, X5R | C_0603_1608Metric | Murata | GRM188R61A106ME69D | C90053 (https://www.lcsc.com/product-detail/C90053.html) | 20% | 10V |  | X5R | 10uF; 10V; 20%; verify DC-bias derating |  | 2026-09-20 | 114880
Common | Standard | Populate | D1 | 1 | Blue | Light emitting diode | LED_0402_1005Metric_Blue | XINGLIGHT | XL-1005UBC | C22355736 (https://www.lcsc.com/product-detail/C22355736.html) |  |  |  |  |  |  | 2026-09-20 | 267000
Common | Standard | DNP | J1 | 1 | Conn_01x18_Pin | Generic connector, single row, 01x18, script generated | PinHeader_1x18_P2.54mm_Vertical | DNP | DNP | DNP |  |  |  |  |  |  |  |  |  | DNP by design: retain the 1x18 plated through-holes on the PCB for optional access; do not install or purchase a pin header.
Common | Standard | Populate | L1 | 1 | XFL4015-471MEC | Inductor | IND_XFL4015_COC | Coilcraft | XFL4015-471MEC | C18221164 (https://www.lcsc.com/product-detail/C18221164.html) |  |  |  |  | 0.47 uH shielded power inductor; saturation current and DCR suitable for TPS63802 |  | 2026-09-20 | 4067
Common | Standard | Populate | R1, R2 | 2 | 100k | Resistor | R_0402_1005Metric | Yageo | RC0402FR-07100KL | C60491 (https://www.lcsc.com/product-detail/C60491.html) | 1% |  | 0.063 W |  | 100k; 0402 unless footprint states otherwise; verify tolerance and power |  | 2026-09-20 | 8343600
Common | Standard | Populate | R3, R4 | 2 | 10 | Resistor | R_0402_1005Metric | Yageo | RC0402FR-0710RL | C138066 (https://www.lcsc.com/product-detail/C138066.html) | 1% |  | 0.063 W |  | 10; 0402 unless footprint states otherwise; verify tolerance and power |  | 2026-09-20 | 1512400
Common | Standard | Populate | R5 | 1 | 604k | Resistor | R_0402_1005Metric | Vishay | CRCW0402604KFKED | C2085221 (https://www.lcsc.com/product-detail/C2085221.html) | 1% |  | 0.063 W |  | 604k; 0402 unless footprint states otherwise; verify tolerance and power |  | 2026-09-20 | 400
Common | Standard | Populate | R6 | 1 | 91k | Resistor | R_0402_1005Metric | Yageo | AC0402FR-0791KL | C144733 (https://www.lcsc.com/product-detail/C144733.html) | 1% |  | 0.063 W |  | 91k; 0402 unless footprint states otherwise; verify tolerance and power |  | 2026-09-20 | 44500
Common | Standard | Populate | R15, R17 | 2 | 2.2k | Resistor | R_0402_1005Metric | Yageo | RC0402FR-072K2L | C114762 (https://www.lcsc.com/product-detail/C114762.html) | 1% |  | 0.063 W |  | 2.2k; 0402 unless footprint states otherwise; verify tolerance and power |  | 2026-09-20 | 1356300
Common | Standard | Populate | R16 | 1 | 1k | Resistor | R_0402_1005Metric | Yageo | RC0402FR-071KL | C106235 (https://www.lcsc.com/product-detail/C106235.html) | 1% |  | 0.063 W |  | 1k; 0402 unless footprint states otherwise; verify tolerance and power |  | 2026-09-20 | 2630200
Common | Standard | Populate | U1 | 1 | TPS63802DLAR | Buck-Boost | DLA0010A | Texas Instruments | TPS63802DLAR | C2845237 (https://www.lcsc.com/product-detail/C2845237.html) |  |  |  |  | Exact manufacturer ordering code and verified footprint | https://www.ti.com/lit/gpn/tps63802 | 2026-09-20 | 6650
Common | Standard | Populate | U2 | 1 | NCV8705MT33TCG | 500 mA ultra-low-noise 3.3 V LDO, WDFN6, onsemi | WDFN6_2X2_ONS_NCV8705 | onsemi | NCV8705MT33TCG | C604084 (https://www.lcsc.com/product-detail/C604084.html) |  |  |  |  | Exact manufacturer ordering code and verified footprint | ${KIPRJMOD}/../datasheets/NCV8705.pdf | 2026-09-20 | 4476
Common | Standard | Populate | U3 | 1 | MCP1700T-3002E_TT | MCP1700T-3002E/TT,LDOVoltage Regulator,250mA,3V +/-2%,2.3 to 6Vin,3-Pin SOT-23 | Microchip Technology Inc. MCP1700T-3002E/TT | SOT95P237X112-3N_MCP1700 | Microchip Technology | MCP1700T-3002E/TT | C62244 (https://www.lcsc.com/product-detail/C62244.html) |  |  |  |  | Exact manufacturer ordering code and verified footprint |  | 2026-09-20 | 2870
Common | Standard | Populate | U5 | 1 | BMM350 | Magnetomoer | BGA9_BMM350_BOS | Bosch Sensortec | BMM350 | C17225907 (https://www.lcsc.com/product-detail/C17225907.html) |  |  |  |  | Exact manufacturer ordering code and verified footprint |  | 2026-09-20 | 2789
Common | Standard | Populate | U6 | 1 | BMP581 | Barometer | QFN10_BMP581_BOS | Bosch Sensortec | BMP581 | C5362283 (https://www.lcsc.com/product-detail/C5362283.html) |  |  |  |  | Exact manufacturer ordering code and verified footprint |  | 2026-09-20 | 4000
Common | Standard | Populate | U7 | 1 | BMI323 | IMU | BMI323_BOS | Bosch Sensortec | BMI323 | C5368700 (https://www.lcsc.com/product-detail/C5368700.html) |  |  |  |  | Exact manufacturer ordering code and verified footprint |  | 2026-09-20 | 3524
Common | Standard | Populate | U8 | 1 | MCP1700T-1802E/TT | LDO Regulator | SOT95P237X112-3N_MCP1700_1802 | Microchip Technology | MCP1700T-1802E/TT | C150796 (https://www.lcsc.com/product-detail/C150796.html) |  |  |  |  | Exact manufacturer ordering code and verified footprint |  | 2026-09-20 | 3779
MAX-M10S | Assembly configuration | PCB feature | JP2 | 1 | MAX PPS | Solder Jumper, 2-pole, closed/bridged | Jumper_2_NC_Trace | DNP |  | DNP |  |  |  |  |  |  |  |  |  | MAX assembly default: leave normally-closed copper trace intact; D3 indicator return enabled.
MAX-M10S | Assembly configuration | PCB feature | JP4 | 1 | MAX Enable Bias | Solder Jumper, 2-pole, open: disabled bias, closed: 3V bias enabled | Jumper_2_NO | DNP |  | DNP |  |  |  |  |  |  |  |  |  | MAX assembly default: leave open for passive antenna. Bridge only for a separately reviewed active-antenna build.
MAX-M10S | Assembly configuration | PCB feature | JP5, JP6 | 2 | MAX Enable I2C | Solder Jumper, 2-pole, open: disabled bias, closed: 3V bias enabled | Jumper_2_NO | DNP |  | DNP |  |  |  |  |  |  |  |  |  | MAX assembly default: leave both open; UART interface used.
MAX-M10S | Assembly configuration | PCB feature | TP3, TP4, TP5 | 3 | MAX INT, PPS, SAFE | Test Point | TestPoint-1.0mm | DNP |  | DNP |  |  |  |  |  |  |  |  |  | Bare PCB test pads for MAX option; no components or assembly operation.
MAX-M10S | Standard | Populate | C5, C6, C15 | 3 | 0.1uF | Unpolarized capacitor | C_0402_1005Metric | Murata | GRM155R71C104KA88D | C71629 (https://www.lcsc.com/product-detail/C71629.html) | 10% | 16V |  | X7R | 0.1uF; 16V; 10%; verify DC-bias derating |  | 2026-09-20 | 2302200
MAX-M10S | Standard | Populate | C7 | 1 | 1.0uF | Unpolarized capacitor | C_0402_1005Metric | Murata | GRM155R61C105KE01D | C77007 (https://www.lcsc.com/product-detail/C77007.html) | 10% | 16V |  | X5R | 1.0uF; 16V; 10%; verify DC-bias derating |  | 2026-09-20 | 279200
MAX-M10S | Standard | Populate | C16 | 1 | 10nF X7R | Unpolarized capacitor | C_0402_1005Metric | Murata | GRM155R71C103KA01J | C3011655 (https://www.lcsc.com/product-detail/C3011655.html) | 10% | 16V |  | X7R | Use exact documented part unless engineering review approves a replacement |  | 2026-09-20 | 9900
MAX-M10S | Standard | Populate | D2 | 1 | PESD0402-140 | 40V Clamp - Ipp Tvs Diode | DIO_PESD0402-140 | Littelfuse | PESD0402-140 | C10662 (https://www.lcsc.com/product-detail/C10662.html) |  |  |  |  | Exact manufacturer ordering code and verified footprint |  | 2026-09-20 | 73695
MAX-M10S | Standard | Populate | D3 | 1 | Yellow | Light emitting diode | LED_0402_1005Metric | XINGLIGHT | XL-1005UYC | C25503856 (https://www.lcsc.com/product-detail/C25503856.html) |  |  |  |  |  |  | 2026-09-20 | 77500
MAX-M10S | Standard | Populate | IC1 | 1 | MAX-M10S-00B | GPS Modules u-blox M10 GNSS LCC module, firmware in ROM, SAW filter, LNA | MAXM10S00B | u-blox | MAX-M10S-00B | C4153167 (https://www.lcsc.com/product-detail/C4153167.html) |  |  |  |  | Exact manufacturer ordering code and verified footprint | https://content.u-blox.com/sites/default/files/MAX-M10S_IntegrationManual_UBX-20053088.pdf | 2026-09-20 | 763 |  | Mutually exclusive GNSS assembly option
MAX-M10S | Standard | Populate | J2 | 1 | U.FL-R-SMT-1_10_ | U.FL (UMCC) Connector Receptacle, Male Pin 50 Ohms Surface Mount Solder | HRS_U.FL-R-SMT-1_10_ | Hirose | U.FL-R-SMT-1(10) | C88373 (https://www.lcsc.com/product-detail/C88373.html) |  |  |  |  | Exact manufacturer ordering code and verified footprint |  | 2026-09-20 | 8975
MAX-M10S | Standard | Populate | L2 | 1 | 27nH | Inductor, Murata LQG15H, LQW15A Series 27nH 5% | L_0402_1005Metric | Murata | LQG15HN27NH02D | C1331771 (https://www.lcsc.com/product-detail/C1331771.html) |  |  |  |  | 27 nH, 3%, >=300 mA, 0402 RF choke; exact selected part |  | 2026-09-20 | 4800
MAX-M10S | Standard | Populate | R7, R8, R9, R10, R11, R13, R14 | 7 | 33 | Resistor | R_0402_1005Metric | Yageo | RC0402FR-0733RL | C138002 (https://www.lcsc.com/product-detail/C138002.html) | 1% |  | 0.063 W |  | 33; 0402 unless footprint states otherwise; verify tolerance and power |  | 2026-09-20 | 8094900
MAX-M10S | Standard | DNP | R12 | 1 | DNP (33) | Resistor | R_0402_1005Metric | Yageo | RC0402FR-0733RL | C138002 (https://www.lcsc.com/product-detail/C138002.html) | 1% |  | 0.063 W |  | DNP (33); 0402 unless footprint states otherwise; verify tolerance and power |  | 2026-09-20 | 8094900 |  | DNP by default; controlled recovery access only
MAX-M10S | Standard | Populate | R18 | 1 | 1k | Resistor | R_0402_1005Metric | Yageo | RC0402FR-071KL | C106235 (https://www.lcsc.com/product-detail/C106235.html) | 1% |  | 0.063 W |  | 1k; 0402 unless footprint states otherwise; verify tolerance and power |  | 2026-09-20 | 2630200
MAX-M10S | Standard | Populate | R40 | 1 | 10 | Resistor | R_1210_3225Metric | Vishay | CRCW121010R0FKEAHP | C844442 (https://www.lcsc.com/product-detail/C844442.html) | 1% |  | 0.75 W at 70 degC | Thick film | 10 ohm; 1%; 1 W; 1210; withstand active-antenna short-circuit current |  | 2026-09-21 | 8610 | No 1 W 1210 LCSC substitute approved | LCSC-SOURCED, FAULT CASE OPEN: Vishay CRCW121010R0FKEAHP is 10 ohm, 1%, 0.75 W, 1210 and was in stock at check. MAX-M10S 250 mA is an absolute-maximum source-current rating, not a guaranteed clamp. A hard short at 3.3 V across 10 ohm would dissipate 1.09 W (1.30 W at 3.6 V) if supply remains up. Verify actual short-current limiting or add fault protection before approving sustained-short operation.

Sheet: ZED Production
Variant | Option | Populate / DNP | References | Qty | Value | Description | KiCad Footprint | Manufacturer / Preference | Manufacturer Part Number | LCSC / approved supplier part # | Tolerance | Voltage Rating | Power / Current Rating | Dielectric / Material | Minimum Engineering Requirements | Datasheet | Stock Check Date | Stock at Check | Approved Alternate | Notes | Approved supplier part #
Common | Assembly configuration | PCB feature | JP1 | 1 | I2C pull up | Solder Jumper, 3-pole, open | Jumper_3_NO | DNP |  | DNP |  |  |  |  |  |  |  |  |  | Assembly default: all three contacts open; no common I2C pull-up selected.
Common | Assembly configuration | PCB feature | JP3 | 1 | LED ON | Jumper, 2-pole, open | Jumper_2_NO_NoSilk | DNP |  | DNP |  |  |  |  |  |  |  |  |  | Assembly default: leave open; common D1 LED fitted but disabled.
Common | Assembly configuration | PCB feature | TP1, TP2 | 2 | GNSS 3V3, V_BACKUP | Test Point | TestPoint-1.0mm | DNP |  | DNP |  |  |  |  |  |  |  |  |  | Bare PCB test pads; no components or assembly operation.
Common | Graphic | No purchase | G1 | 1 | Creative Commons logo | Padless Creative Commons PCB graphic | PCM_SparkFun-Aesthetic:Creative_Commons_License |  |  |  |  |  |  |  | No purchased component |  |  |  |  | Padless Creative Commons graphic on saved PCB; no purchased part.
Common | Graphic | No purchase | G*** | 1 | OSHW logo | Padless OSHW silkscreen graphic | OSHW-logo_silkscreen-back_4mm |  |  |  |  |  |  |  | No purchased component |  |  |  |  | Padless OSHW logo graphic on saved PCB; no purchased part.
Common | Mechanical | No purchase | H1, H2, H3, H4 | 4 | Mounting Hole | Mounting Hole without connection | MountingHole_3.5mm | DNP |  | DNP
Common | Standard | Populate | C1 | 1 | 10uF | Unpolarized capacitor, X5R/X7R | C_0603_1608Metric | Murata | GRM188R60J106ME47D | C77041 (https://www.lcsc.com/product-detail/C77041.html) | 20% | 6.3V |  | X5R | 10uF; 6.3V; 20%; verify DC-bias derating |  | 2026-09-20 | 204650
Common | Standard | Populate | C2, C3, C22, C23 | 4 | 1.0uF | Unpolarized capacitor | C_0402_1005Metric | Murata | GRM155R61C105KE01D | C77007 (https://www.lcsc.com/product-detail/C77007.html) | 10% | 16V |  | X5R | 1.0uF; 16V; 10%; verify DC-bias derating |  | 2026-09-20 | 279200
Common | Standard | Populate | C4 | 1 | 22uF | Unpolarized capacitor, X5R | C_0603_1608Metric | Murata | GRM188R61A226ME15D | C84419 (https://www.lcsc.com/product-detail/C84419.html) | 20% | 10V |  | X5R | 22uF; 10V; 20%; verify DC-bias derating |  | 2026-09-20 | 516685
Common | Standard | Populate | C8, C9, C10, C11, C13, C14 | 6 | 0.1uF | Unpolarized capacitor | C_0402_1005Metric | Murata | GRM155R71C104KA88D | C71629 (https://www.lcsc.com/product-detail/C71629.html) | 10% | 16V |  | X7R | 0.1uF; 16V; 10%; verify DC-bias derating |  | 2026-09-20 | 2302200
Common | Standard | Populate | C12 | 1 | 2.2uF | BMM350 CRST capacitor, 2.2 uF, low ESR/ESL, nonmagnetic required | C_0805_2012Metric | Samsung | CL21B225KOFNNNE | C28234 (https://www.lcsc.com/product-detail/C28234.html) | 10% | 16V |  | X7R | 2.2 uF; >=6.3 V; 10%; X7R; low ESR/ESL; nonmagnetic; 0805; place at BMM350 CRST |  | 2026-09-20 | 79940 | Engineering exception accepted: Samsung CL21B225KOFNNNE | SELECTED: Samsung CL21B225KOFNNNE matches 2.2 uF, 10%, X7R, 16 V and 0805 and was in stock. It replaces the obsolete Bosch-recommended TDK part. Samsung does not specify nonmagnetic construction; validate installed-board BMM350 magnetic offsets.
Common | Standard | Populate | C17 | 1 | 22uF | Unpolarized capacitor, X5R/X7R | C_0603_1608Metric | Murata | GRM188R61A226ME15D | C84419 (https://www.lcsc.com/product-detail/C84419.html) | 20% | 10V |  | X5R | 22uF; 10V; 20%; verify DC-bias derating |  | 2026-09-20 | 516685
Common | Standard | Populate | C18, C19 | 2 | 10uF | Unpolarized capacitor, X5R | C_0603_1608Metric | Murata | GRM188R61A106ME69D | C90053 (https://www.lcsc.com/product-detail/C90053.html) | 20% | 10V |  | X5R | 10uF; 10V; 20%; verify DC-bias derating |  | 2026-09-20 | 114880
Common | Standard | Populate | D1 | 1 | Blue | Light emitting diode | LED_0402_1005Metric_Blue | XINGLIGHT | XL-1005UBC | C22355736 (https://www.lcsc.com/product-detail/C22355736.html) |  |  |  |  |  |  | 2026-09-20 | 267000
Common | Standard | DNP | J1 | 1 | Conn_01x18_Pin | Generic connector, single row, 01x18, script generated | PinHeader_1x18_P2.54mm_Vertical | DNP | DNP | DNP |  |  |  |  |  |  |  |  |  | DNP by design: retain the 1x18 plated through-holes on the PCB for optional access; do not install or purchase a pin header.
Common | Standard | Populate | L1 | 1 | XFL4015-471MEC | Inductor | IND_XFL4015_COC | Coilcraft | XFL4015-471MEC | C18221164 (https://www.lcsc.com/product-detail/C18221164.html) |  |  |  |  | 0.47 uH shielded power inductor; saturation current and DCR suitable for TPS63802 |  | 2026-09-20 | 4067
Common | Standard | Populate | R1, R2 | 2 | 100k | Resistor | R_0402_1005Metric | Yageo | RC0402FR-07100KL | C60491 (https://www.lcsc.com/product-detail/C60491.html) | 1% |  | 0.063 W |  | 100k; 0402 unless footprint states otherwise; verify tolerance and power |  | 2026-09-20 | 8343600
Common | Standard | Populate | R3, R4 | 2 | 10 | Resistor | R_0402_1005Metric | Yageo | RC0402FR-0710RL | C138066 (https://www.lcsc.com/product-detail/C138066.html) | 1% |  | 0.063 W |  | 10; 0402 unless footprint states otherwise; verify tolerance and power |  | 2026-09-20 | 1512400
Common | Standard | Populate | R5 | 1 | 604k | Resistor | R_0402_1005Metric | Vishay | CRCW0402604KFKED | C2085221 (https://www.lcsc.com/product-detail/C2085221.html) | 1% |  | 0.063 W |  | 604k; 0402 unless footprint states otherwise; verify tolerance and power |  | 2026-09-20 | 400
Common | Standard | Populate | R6 | 1 | 91k | Resistor | R_0402_1005Metric | Yageo | AC0402FR-0791KL | C144733 (https://www.lcsc.com/product-detail/C144733.html) | 1% |  | 0.063 W |  | 91k; 0402 unless footprint states otherwise; verify tolerance and power |  | 2026-09-20 | 44500
Common | Standard | Populate | R15, R17 | 2 | 2.2k | Resistor | R_0402_1005Metric | Yageo | RC0402FR-072K2L | C114762 (https://www.lcsc.com/product-detail/C114762.html) | 1% |  | 0.063 W |  | 2.2k; 0402 unless footprint states otherwise; verify tolerance and power |  | 2026-09-20 | 1356300
Common | Standard | Populate | R16 | 1 | 1k | Resistor | R_0402_1005Metric | Yageo | RC0402FR-071KL | C106235 (https://www.lcsc.com/product-detail/C106235.html) | 1% |  | 0.063 W |  | 1k; 0402 unless footprint states otherwise; verify tolerance and power |  | 2026-09-20 | 2630200
Common | Standard | Populate | U1 | 1 | TPS63802DLAR | Buck-Boost | DLA0010A | Texas Instruments | TPS63802DLAR | C2845237 (https://www.lcsc.com/product-detail/C2845237.html) |  |  |  |  | Exact manufacturer ordering code and verified footprint | https://www.ti.com/lit/gpn/tps63802 | 2026-09-20 | 6650
Common | Standard | Populate | U2 | 1 | NCV8705MT33TCG | 500 mA ultra-low-noise 3.3 V LDO, WDFN6, onsemi | WDFN6_2X2_ONS_NCV8705 | onsemi | NCV8705MT33TCG | C604084 (https://www.lcsc.com/product-detail/C604084.html) |  |  |  |  | Exact manufacturer ordering code and verified footprint | ${KIPRJMOD}/../datasheets/NCV8705.pdf | 2026-09-20 | 4476
Common | Standard | Populate | U3 | 1 | MCP1700T-3002E_TT | MCP1700T-3002E/TT,LDOVoltage Regulator,250mA,3V +/-2%,2.3 to 6Vin,3-Pin SOT-23 | Microchip Technology Inc. MCP1700T-3002E/TT | SOT95P237X112-3N_MCP1700 | Microchip Technology | MCP1700T-3002E/TT | C62244 (https://www.lcsc.com/product-detail/C62244.html) |  |  |  |  | Exact manufacturer ordering code and verified footprint |  | 2026-09-20 | 2870
Common | Standard | Populate | U5 | 1 | BMM350 | Magnetomoer | BGA9_BMM350_BOS | Bosch Sensortec | BMM350 | C17225907 (https://www.lcsc.com/product-detail/C17225907.html) |  |  |  |  | Exact manufacturer ordering code and verified footprint |  | 2026-09-20 | 2789
Common | Standard | Populate | U6 | 1 | BMP581 | Barometer | QFN10_BMP581_BOS | Bosch Sensortec | BMP581 | C5362283 (https://www.lcsc.com/product-detail/C5362283.html) |  |  |  |  | Exact manufacturer ordering code and verified footprint |  | 2026-09-20 | 4000
Common | Standard | Populate | U7 | 1 | BMI323 | IMU | BMI323_BOS | Bosch Sensortec | BMI323 | C5368700 (https://www.lcsc.com/product-detail/C5368700.html) |  |  |  |  | Exact manufacturer ordering code and verified footprint |  | 2026-09-20 | 3524
Common | Standard | Populate | U8 | 1 | MCP1700T-1802E/TT | LDO Regulator | SOT95P237X112-3N_MCP1700_1802 | Microchip Technology | MCP1700T-1802E/TT | C150796 (https://www.lcsc.com/product-detail/C150796.html) |  |  |  |  | Exact manufacturer ordering code and verified footprint |  | 2026-09-20 | 3779
ZED-F9P | Assembly configuration | PCB feature | JP7, JP9, JP10 | 3 | ZED PPS, RTK, GEOFENCE | Solder Jumper, 2-pole, closed/bridged | Jumper_2_NC_Trace | DNP |  | DNP |  |  |  |  |  |  |  |  |  | ZED assembly default: leave all three normally-closed indicator-return traces intact.
ZED-F9P | Assembly configuration | PCB feature | JP8 | 1 | DZED _SEL | Open selects UART & I2C, Close select SPI | Jumper_2_NO | DNP |  | DNP |  |  |  |  |  |  |  |  |  | ZED assembly default: leave open for UART/I2C mode, not SPI.
ZED-F9P | Assembly configuration | PCB feature | JP11 | 1 | ZED Enable Bias | Normally closed antenna-bias disconnect jumper | Jumper_2_NC_Trace | DNP |  | DNP |  |  |  |  |  |  |  |  |  | ZED assembly default: leave normally-closed antenna-bias trace intact.
ZED-F9P | Assembly configuration | PCB feature | JP12, JP13 | 2 | ZED Enable I2C | Solder Jumper, 2-pole, open: disabled bias, closed: 3V bias enabled | Jumper_2_NO | DNP |  | DNP |  |  |  |  |  |  |  |  |  | ZED assembly default: leave both open; UART interface used.
ZED-F9P | Assembly configuration | PCB feature | JP14 | 1 | USB omitted: ground V_USB | Close only when USB option is omitted; mutually exclusive with U4 output | Jumper_2_NO | DNP |  | DNP |  |  |  |  |  |  |  |  |  | ZED Production: bridge closed to ground V_USB because USB parts are DNP. ZED Development: leave open with U4 populated. Never close with USB LDO active.
ZED-F9P | Assembly configuration | PCB feature | TP6, TP7, TP8 | 3 | ZED INT, PPS, SAFE | Test Point | TestPoint-1.0mm | DNP |  | DNP |  |  |  |  |  |  |  |  |  | Bare PCB test pads for ZED option; no components or assembly operation.
ZED-F9P | Development USB | DNP | C21, C24 | 2 | 1.0uF | Unpolarized capacitor | C_0402_1005Metric | Murata | GRM155R61C105KE01D | C77007 (https://www.lcsc.com/product-detail/C77007.html) | 10% | 16V |  | X5R | 1.0uF; 16V; 10%; verify DC-bias derating |  | 2026-09-20 | 279200 |  | Populate only for ZED development USB build; DNP in final product
ZED-F9P | Development USB | DNP | C28 | 1 | 1.0uF | Unpolarized capacitor | C_0402_1005Metric | Murata | GRM155R61C105KE01D | C77007 (https://www.lcsc.com/product-detail/C77007.html) | 10% | 16V |  | X5R | 1.0uF; 16V; 10%; verify DC-bias derating |  | 2026-09-20 | 279200 |  | Populate only for ZED development USB build; DNP in final product
ZED-F9P | Development USB | DNP | D8 | 1 | USBLC6-2SC6 | 17V Clamp 5A (8/20µs) Ipp Tvs Diode | USBLC6-2SC6_SOT23-6L | STMicroelectronics | USBLC6-2SC6 | C7519 (https://www.lcsc.com/product-detail/C7519.html) |  |  |  |  | Exact manufacturer ordering code and verified footprint | https://www.st.com/resource/en/datasheet/usblc6-2.pdf | 2026-09-20 | 21165 |  | Populate only for ZED development USB build; DNP in final product
ZED-F9P | Development USB | DNP | J4 | 1 | USB4120-03-C | USB C receptacle | USB4120-03-C_GCT | GCT | USB4120-03-C | C3445864 (https://www.lcsc.com/product-detail/C3445864.html) |  |  |  |  | Exact manufacturer ordering code and verified footprint | https://gct.co/connector/usb4120 | 2026-09-20 | 557 |  | Populate only for ZED development USB build; DNP in final product
ZED-F9P | Development USB | DNP | R34, R35 | 2 | 5.1k | Resistor | R_0402_1005Metric | Yageo | RC0402FR-075K1L | C105872 (https://www.lcsc.com/product-detail/C105872.html) | 1% |  | 0.063 W |  | 5.1k; 0402 unless footprint states otherwise; verify tolerance and power |  | 2026-09-20 | 2165200 |  | Populate only for ZED development USB build; DNP in final product
ZED-F9P | Development USB | DNP | R38, R39 | 2 | 27 | Resistor | R_0402_1005Metric | Yageo | RC0402FR-0727RL | C138021 (https://www.lcsc.com/product-detail/C138021.html) | 1% |  | 0.063 W |  | 27; 0402 unless footprint states otherwise; verify tolerance and power |  | 2026-09-20 | 35300 |  | Populate only for ZED development USB build; DNP in final product
ZED-F9P | Development USB | DNP | R41 | 1 | 100k | Resistor | R_0402_1005Metric | Yageo | RC0402FR-07100KL | C60491 (https://www.lcsc.com/product-detail/C60491.html) | 1% |  | 0.063 W |  | 100k; 0402 unless footprint states otherwise; verify tolerance and power |  | 2026-09-20 | 8343600 |  | Populate only for ZED development USB build; DNP in final product
ZED-F9P | Development USB | DNP | U4 | 1 | AP2112K-3.3TRG1 | LDO Regulator | SOT_RG1_DIO_AP2112K | Diodes Incorporated | AP2112K-3.3TRG1 | C51118 (https://www.lcsc.com/product-detail/C51118.html) |  |  |  |  | Exact manufacturer ordering code and verified footprint | ${KIPRJMOD}/../datasheets/AP2112.pdf | 2026-09-20 | 52940 |  | Populate only for ZED development USB build; DNP in final product
ZED-F9P | Standard | Populate | C20 | 1 | 100nF | Murata GRM155R71C104JA88D, 100 nF, 5%, 16 V, X7R, 0402 | C_0402_1005Metric | Murata | GRM155R71C104JA88D | C913742 (https://www.lcsc.com/product-detail/C913742.html) | 5% | 16V |  | X7R | Use exact documented part unless engineering review approves a replacement |  | 2026-09-20 | 17050
ZED-F9P | Standard | Populate | C25 | 1 | 2.2uF | Unpolarized capacitor | C_0402_1005Metric | Murata | GRM155R61C225KE44D | C335109 (https://www.lcsc.com/product-detail/C335109.html) | 10% | 16V |  | X5R | 2uF; 16V; 10%; verify DC-bias derating |  | 2026-09-20 | 24100
ZED-F9P | Standard | Populate | C26 | 1 | 0.1uF | Unpolarized capacitor | C_0402_1005Metric | Murata | GRM155R71C104KA88D | C71629 (https://www.lcsc.com/product-detail/C71629.html) | 10% | 16V |  | X7R | 0.1uF; 16V; 10%; verify DC-bias derating |  | 2026-09-20 | 2302200
ZED-F9P | Standard | Populate | C27 | 1 | 1.0uF | Unpolarized capacitor | C_0402_1005Metric | Murata | GRM155R61C105KE01D | C77007 (https://www.lcsc.com/product-detail/C77007.html) | 10% | 16V |  | X5R | 1.0uF; 16V; 10%; verify DC-bias derating |  | 2026-09-20 | 279200
ZED-F9P | Standard | Populate | D4 | 1 | PESD0402-140 | 40V Clamp - Ipp Tvs Diode | DIO_PESD0402-140 | Littelfuse | PESD0402-140 | C10662 (https://www.lcsc.com/product-detail/C10662.html) |  |  |  |  | Exact manufacturer ordering code and verified footprint |  | 2026-09-20 | 73695
ZED-F9P | Standard | Populate | D5 | 1 | Yellow | Light emitting diode | LED_0402_1005Metric_Red | XINGLIGHT | XL-1005UYC | C25503856 (https://www.lcsc.com/product-detail/C25503856.html) |  |  |  |  |  |  | 2026-09-20 | 77500
ZED-F9P | Standard | Populate | D6 | 1 | GREEN | Light emitting diode | LED_0402_1005Metric_Red | XINGLIGHT | XL-1005UGC | C965793 (https://www.lcsc.com/product-detail/C965793.html) |  |  |  |  |  |  | 2026-09-20 | 1209750
ZED-F9P | Standard | Populate | D7 | 1 | BLUE | Light emitting diode | LED_0402_1005Metric_Red | XINGLIGHT | XL-1005UBC | C22355736 (https://www.lcsc.com/product-detail/C22355736.html) |  |  |  |  |  |  | 2026-09-20 | 267000
ZED-F9P | Standard | Populate | IC2 | 1 | ZED-F9P-05B | GNSS / GPS Modules High Precision Multi-band RTK GNSS module, with Galileo OSNMA | ZEDF9P05B | u-blox | ZED-F9P-05B | Mouser 134-ZED-F9P-05B |  |  |  |  | Exact manufacturer ordering code and verified footprint | https://www.u-blox.com/en/product/zed-f9p-module | 2026-09-21 | 791 | ZED-F9P-04B / LCSC C5120257 only after hardware, firmware, and feature revision review | APPROVED MOUSER SOURCE: 134-ZED-F9P-05B matches exact u-blox ZED-F9P-05B. LCSC C5120257 is -04B and is not approved as a substitute. | Mouser 134-ZED-F9P-05B
ZED-F9P | Standard | Populate | J3 | 1 | U.FL-R-SMT-1_10_ | U.FL (UMCC) Connector Receptacle, Male Pin 50 Ohms Surface Mount Solder | HRS_U.FL-R-SMT-1_10_ | Hirose | U.FL-R-SMT-1(10) | C88373 (https://www.lcsc.com/product-detail/C88373.html) |  |  |  |  | Exact manufacturer ordering code and verified footprint |  | 2026-09-20 | 8975
ZED-F9P | Standard | Populate | L3 | 1 | 47nH | Inductor, Murata LQG15H, LQW15A Series 47nH 5% | L_0402_1005Metric | Murata | LQG15HS47NJ02D | C97998 (https://www.lcsc.com/product-detail/C97998.html) |  |  |  |  | 47 nH, 5%, >=300 mA, >500 ohm impedance from 1-1.8 GHz, 0402; exact selected part |  | 2026-09-20 | 56050
ZED-F9P | Standard | Populate | R20, R22, R23, R24, R25, R26, R27, R31, R33, R36, R37 | 11 | 33 | Resistor | R_0402_1005Metric | Yageo | RC0402FR-0733RL | C138002 (https://www.lcsc.com/product-detail/C138002.html) | 1% |  | 0.063 W |  | 33; 0402 unless footprint states otherwise; verify tolerance and power |  | 2026-09-20 | 8094900
ZED-F9P | Standard | Populate | R21, R29, R30 | 3 | 1k | Resistor | R_0402_1005Metric | Yageo | RC0402FR-071KL | C106235 (https://www.lcsc.com/product-detail/C106235.html) | 1% |  | 0.063 W |  | 1k; 0402 unless footprint states otherwise; verify tolerance and power |  | 2026-09-20 | 2630200
ZED-F9P | Standard | DNP | R28 | 1 | 33 DNP | Resistor | R_0402_1005Metric | Yageo | RC0402FR-0733RL | C138002 (https://www.lcsc.com/product-detail/C138002.html) | 1% |  | 0.063 W |  | 33 DNP; 0402 unless footprint states otherwise; verify tolerance and power |  | 2026-09-20 | 8094900 |  | DNP by default; controlled recovery access only
ZED-F9P | Standard | Populate | R32 | 1 | 10 | Resistor | R_2010_5025Metric | Bourns | CMP2010-FX-10R0ELF | C1880468 (https://www.lcsc.com/product-detail/C1880468.html) | 1% | 200 V | 1 W at ambient <=70 degC; derate above 70 degC | Thick film, high-power anti-surge | 10 ohm; 1%; >=1 W; 2010; withstand active-antenna short-circuit current | ${KIPRJMOD}/../datasheets/Bourns_CMP.pdf | 2026-09-20 | 1595 |  | Approved and implemented selection for the ZED-F9P antenna-bias current limiter. LCSC identity, 10 ohm, 1%, 1 W, 2010 package, and availability verified 2026-09-20. The saved schematic and PCB use R_2010_5025Metric; placement and routing are complete, with zero unconnected items in the post-layout DRC.

Sheet: ZED Development
Variant | Option | Populate / DNP | References | Qty | Value | Description | KiCad Footprint | Manufacturer / Preference | Manufacturer Part Number | LCSC / approved supplier part # | Tolerance | Voltage Rating | Power / Current Rating | Dielectric / Material | Minimum Engineering Requirements | Datasheet | Stock Check Date | Stock at Check | Approved Alternate | Notes | Approved supplier part #
Common | Assembly configuration | PCB feature | JP1 | 1 | I2C pull up | Solder Jumper, 3-pole, open | Jumper_3_NO | DNP |  | DNP |  |  |  |  |  |  |  |  |  | Assembly default: all three contacts open; no common I2C pull-up selected.
Common | Assembly configuration | PCB feature | JP3 | 1 | LED ON | Jumper, 2-pole, open | Jumper_2_NO_NoSilk | DNP |  | DNP |  |  |  |  |  |  |  |  |  | Assembly default: leave open; common D1 LED fitted but disabled.
Common | Assembly configuration | PCB feature | TP1, TP2 | 2 | GNSS 3V3, V_BACKUP | Test Point | TestPoint-1.0mm | DNP |  | DNP |  |  |  |  |  |  |  |  |  | Bare PCB test pads; no components or assembly operation.
Common | Graphic | No purchase | G1 | 1 | Creative Commons logo | Padless Creative Commons PCB graphic | PCM_SparkFun-Aesthetic:Creative_Commons_License |  |  |  |  |  |  |  | No purchased component |  |  |  |  | Padless Creative Commons graphic on saved PCB; no purchased part.
Common | Graphic | No purchase | G*** | 1 | OSHW logo | Padless OSHW silkscreen graphic | OSHW-logo_silkscreen-back_4mm |  |  |  |  |  |  |  | No purchased component |  |  |  |  | Padless OSHW logo graphic on saved PCB; no purchased part.
Common | Mechanical | No purchase | H1, H2, H3, H4 | 4 | Mounting Hole | Mounting Hole without connection | MountingHole_3.5mm | DNP |  | DNP
Common | Standard | Populate | C1 | 1 | 10uF | Unpolarized capacitor, X5R/X7R | C_0603_1608Metric | Murata | GRM188R60J106ME47D | C77041 (https://www.lcsc.com/product-detail/C77041.html) | 20% | 6.3V |  | X5R | 10uF; 6.3V; 20%; verify DC-bias derating |  | 2026-09-20 | 204650
Common | Standard | Populate | C2, C3, C22, C23 | 4 | 1.0uF | Unpolarized capacitor | C_0402_1005Metric | Murata | GRM155R61C105KE01D | C77007 (https://www.lcsc.com/product-detail/C77007.html) | 10% | 16V |  | X5R | 1.0uF; 16V; 10%; verify DC-bias derating |  | 2026-09-20 | 279200
Common | Standard | Populate | C4 | 1 | 22uF | Unpolarized capacitor, X5R | C_0603_1608Metric | Murata | GRM188R61A226ME15D | C84419 (https://www.lcsc.com/product-detail/C84419.html) | 20% | 10V |  | X5R | 22uF; 10V; 20%; verify DC-bias derating |  | 2026-09-20 | 516685
Common | Standard | Populate | C8, C9, C10, C11, C13, C14 | 6 | 0.1uF | Unpolarized capacitor | C_0402_1005Metric | Murata | GRM155R71C104KA88D | C71629 (https://www.lcsc.com/product-detail/C71629.html) | 10% | 16V |  | X7R | 0.1uF; 16V; 10%; verify DC-bias derating |  | 2026-09-20 | 2302200
Common | Standard | Populate | C12 | 1 | 2.2uF | BMM350 CRST capacitor, 2.2 uF, low ESR/ESL, nonmagnetic required | C_0805_2012Metric | Samsung | CL21B225KOFNNNE | C28234 (https://www.lcsc.com/product-detail/C28234.html) | 10% | 16V |  | X7R | 2.2 uF; >=6.3 V; 10%; X7R; low ESR/ESL; nonmagnetic; 0805; place at BMM350 CRST |  | 2026-09-20 | 79940 | Engineering exception accepted: Samsung CL21B225KOFNNNE | SELECTED: Samsung CL21B225KOFNNNE matches 2.2 uF, 10%, X7R, 16 V and 0805 and was in stock. It replaces the obsolete Bosch-recommended TDK part. Samsung does not specify nonmagnetic construction; validate installed-board BMM350 magnetic offsets.
Common | Standard | Populate | C17 | 1 | 22uF | Unpolarized capacitor, X5R/X7R | C_0603_1608Metric | Murata | GRM188R61A226ME15D | C84419 (https://www.lcsc.com/product-detail/C84419.html) | 20% | 10V |  | X5R | 22uF; 10V; 20%; verify DC-bias derating |  | 2026-09-20 | 516685
Common | Standard | Populate | C18, C19 | 2 | 10uF | Unpolarized capacitor, X5R | C_0603_1608Metric | Murata | GRM188R61A106ME69D | C90053 (https://www.lcsc.com/product-detail/C90053.html) | 20% | 10V |  | X5R | 10uF; 10V; 20%; verify DC-bias derating |  | 2026-09-20 | 114880
Common | Standard | Populate | D1 | 1 | Blue | Light emitting diode | LED_0402_1005Metric_Blue | XINGLIGHT | XL-1005UBC | C22355736 (https://www.lcsc.com/product-detail/C22355736.html) |  |  |  |  |  |  | 2026-09-20 | 267000
Common | Standard | DNP | J1 | 1 | Conn_01x18_Pin | Generic connector, single row, 01x18, script generated | PinHeader_1x18_P2.54mm_Vertical | DNP | DNP | DNP |  |  |  |  |  |  |  |  |  | DNP by design: retain the 1x18 plated through-holes on the PCB for optional access; do not install or purchase a pin header.
Common | Standard | Populate | L1 | 1 | XFL4015-471MEC | Inductor | IND_XFL4015_COC | Coilcraft | XFL4015-471MEC | C18221164 (https://www.lcsc.com/product-detail/C18221164.html) |  |  |  |  | 0.47 uH shielded power inductor; saturation current and DCR suitable for TPS63802 |  | 2026-09-20 | 4067
Common | Standard | Populate | R1, R2 | 2 | 100k | Resistor | R_0402_1005Metric | Yageo | RC0402FR-07100KL | C60491 (https://www.lcsc.com/product-detail/C60491.html) | 1% |  | 0.063 W |  | 100k; 0402 unless footprint states otherwise; verify tolerance and power |  | 2026-09-20 | 8343600
Common | Standard | Populate | R3, R4 | 2 | 10 | Resistor | R_0402_1005Metric | Yageo | RC0402FR-0710RL | C138066 (https://www.lcsc.com/product-detail/C138066.html) | 1% |  | 0.063 W |  | 10; 0402 unless footprint states otherwise; verify tolerance and power |  | 2026-09-20 | 1512400
Common | Standard | Populate | R5 | 1 | 604k | Resistor | R_0402_1005Metric | Vishay | CRCW0402604KFKED | C2085221 (https://www.lcsc.com/product-detail/C2085221.html) | 1% |  | 0.063 W |  | 604k; 0402 unless footprint states otherwise; verify tolerance and power |  | 2026-09-20 | 400
Common | Standard | Populate | R6 | 1 | 91k | Resistor | R_0402_1005Metric | Yageo | AC0402FR-0791KL | C144733 (https://www.lcsc.com/product-detail/C144733.html) | 1% |  | 0.063 W |  | 91k; 0402 unless footprint states otherwise; verify tolerance and power |  | 2026-09-20 | 44500
Common | Standard | Populate | R15, R17 | 2 | 2.2k | Resistor | R_0402_1005Metric | Yageo | RC0402FR-072K2L | C114762 (https://www.lcsc.com/product-detail/C114762.html) | 1% |  | 0.063 W |  | 2.2k; 0402 unless footprint states otherwise; verify tolerance and power |  | 2026-09-20 | 1356300
Common | Standard | Populate | R16 | 1 | 1k | Resistor | R_0402_1005Metric | Yageo | RC0402FR-071KL | C106235 (https://www.lcsc.com/product-detail/C106235.html) | 1% |  | 0.063 W |  | 1k; 0402 unless footprint states otherwise; verify tolerance and power |  | 2026-09-20 | 2630200
Common | Standard | Populate | U1 | 1 | TPS63802DLAR | Buck-Boost | DLA0010A | Texas Instruments | TPS63802DLAR | C2845237 (https://www.lcsc.com/product-detail/C2845237.html) |  |  |  |  | Exact manufacturer ordering code and verified footprint | https://www.ti.com/lit/gpn/tps63802 | 2026-09-20 | 6650
Common | Standard | Populate | U2 | 1 | NCV8705MT33TCG | 500 mA ultra-low-noise 3.3 V LDO, WDFN6, onsemi | WDFN6_2X2_ONS_NCV8705 | onsemi | NCV8705MT33TCG | C604084 (https://www.lcsc.com/product-detail/C604084.html) |  |  |  |  | Exact manufacturer ordering code and verified footprint | ${KIPRJMOD}/../datasheets/NCV8705.pdf | 2026-09-20 | 4476
Common | Standard | Populate | U3 | 1 | MCP1700T-3002E_TT | MCP1700T-3002E/TT,LDOVoltage Regulator,250mA,3V +/-2%,2.3 to 6Vin,3-Pin SOT-23 | Microchip Technology Inc. MCP1700T-3002E/TT | SOT95P237X112-3N_MCP1700 | Microchip Technology | MCP1700T-3002E/TT | C62244 (https://www.lcsc.com/product-detail/C62244.html) |  |  |  |  | Exact manufacturer ordering code and verified footprint |  | 2026-09-20 | 2870
Common | Standard | Populate | U5 | 1 | BMM350 | Magnetomoer | BGA9_BMM350_BOS | Bosch Sensortec | BMM350 | C17225907 (https://www.lcsc.com/product-detail/C17225907.html) |  |  |  |  | Exact manufacturer ordering code and verified footprint |  | 2026-09-20 | 2789
Common | Standard | Populate | U6 | 1 | BMP581 | Barometer | QFN10_BMP581_BOS | Bosch Sensortec | BMP581 | C5362283 (https://www.lcsc.com/product-detail/C5362283.html) |  |  |  |  | Exact manufacturer ordering code and verified footprint |  | 2026-09-20 | 4000
Common | Standard | Populate | U7 | 1 | BMI323 | IMU | BMI323_BOS | Bosch Sensortec | BMI323 | C5368700 (https://www.lcsc.com/product-detail/C5368700.html) |  |  |  |  | Exact manufacturer ordering code and verified footprint |  | 2026-09-20 | 3524
Common | Standard | Populate | U8 | 1 | MCP1700T-1802E/TT | LDO Regulator | SOT95P237X112-3N_MCP1700_1802 | Microchip Technology | MCP1700T-1802E/TT | C150796 (https://www.lcsc.com/product-detail/C150796.html) |  |  |  |  | Exact manufacturer ordering code and verified footprint |  | 2026-09-20 | 3779
ZED-F9P | Assembly configuration | PCB feature | JP7, JP9, JP10 | 3 | ZED PPS, RTK, GEOFENCE | Solder Jumper, 2-pole, closed/bridged | Jumper_2_NC_Trace | DNP |  | DNP |  |  |  |  |  |  |  |  |  | ZED assembly default: leave all three normally-closed indicator-return traces intact.
ZED-F9P | Assembly configuration | PCB feature | JP8 | 1 | DZED _SEL | Open selects UART & I2C, Close select SPI | Jumper_2_NO | DNP |  | DNP |  |  |  |  |  |  |  |  |  | ZED assembly default: leave open for UART/I2C mode, not SPI.
ZED-F9P | Assembly configuration | PCB feature | JP11 | 1 | ZED Enable Bias | Normally closed antenna-bias disconnect jumper | Jumper_2_NC_Trace | DNP |  | DNP |  |  |  |  |  |  |  |  |  | ZED assembly default: leave normally-closed antenna-bias trace intact.
ZED-F9P | Assembly configuration | PCB feature | JP12, JP13 | 2 | ZED Enable I2C | Solder Jumper, 2-pole, open: disabled bias, closed: 3V bias enabled | Jumper_2_NO | DNP |  | DNP |  |  |  |  |  |  |  |  |  | ZED assembly default: leave both open; UART interface used.
ZED-F9P | Assembly configuration | PCB feature | JP14 | 1 | USB omitted: ground V_USB | Close only when USB option is omitted; mutually exclusive with U4 output | Jumper_2_NO | DNP |  | DNP |  |  |  |  |  |  |  |  |  | ZED Production: bridge closed to ground V_USB because USB parts are DNP. ZED Development: leave open with U4 populated. Never close with USB LDO active.
ZED-F9P | Assembly configuration | PCB feature | TP6, TP7, TP8 | 3 | ZED INT, PPS, SAFE | Test Point | TestPoint-1.0mm | DNP |  | DNP |  |  |  |  |  |  |  |  |  | Bare PCB test pads for ZED option; no components or assembly operation.
ZED-F9P | Development USB | Populate | C21, C24 | 2 | 1.0uF | Unpolarized capacitor | C_0402_1005Metric | Murata | GRM155R61C105KE01D | C77007 (https://www.lcsc.com/product-detail/C77007.html) | 10% | 16V |  | X5R | 1.0uF; 16V; 10%; verify DC-bias derating |  | 2026-09-20 | 279200 |  | Populate only for ZED development USB build; DNP in final product
ZED-F9P | Development USB | Populate | C28 | 1 | 1.0uF | Unpolarized capacitor | C_0402_1005Metric | Murata | GRM155R61C105KE01D | C77007 (https://www.lcsc.com/product-detail/C77007.html) | 10% | 16V |  | X5R | 1.0uF; 16V; 10%; verify DC-bias derating |  | 2026-09-20 | 279200 |  | Populate only for ZED development USB build; DNP in final product
ZED-F9P | Development USB | Populate | D8 | 1 | USBLC6-2SC6 | 17V Clamp 5A (8/20µs) Ipp Tvs Diode | USBLC6-2SC6_SOT23-6L | STMicroelectronics | USBLC6-2SC6 | C7519 (https://www.lcsc.com/product-detail/C7519.html) |  |  |  |  | Exact manufacturer ordering code and verified footprint | https://www.st.com/resource/en/datasheet/usblc6-2.pdf | 2026-09-20 | 21165 |  | Populate only for ZED development USB build; DNP in final product
ZED-F9P | Development USB | Populate | J4 | 1 | USB4120-03-C | USB C receptacle | USB4120-03-C_GCT | GCT | USB4120-03-C | C3445864 (https://www.lcsc.com/product-detail/C3445864.html) |  |  |  |  | Exact manufacturer ordering code and verified footprint | https://gct.co/connector/usb4120 | 2026-09-20 | 557 |  | Populate only for ZED development USB build; DNP in final product
ZED-F9P | Development USB | Populate | R34, R35 | 2 | 5.1k | Resistor | R_0402_1005Metric | Yageo | RC0402FR-075K1L | C105872 (https://www.lcsc.com/product-detail/C105872.html) | 1% |  | 0.063 W |  | 5.1k; 0402 unless footprint states otherwise; verify tolerance and power |  | 2026-09-20 | 2165200 |  | Populate only for ZED development USB build; DNP in final product
ZED-F9P | Development USB | Populate | R38, R39 | 2 | 27 | Resistor | R_0402_1005Metric | Yageo | RC0402FR-0727RL | C138021 (https://www.lcsc.com/product-detail/C138021.html) | 1% |  | 0.063 W |  | 27; 0402 unless footprint states otherwise; verify tolerance and power |  | 2026-09-20 | 35300 |  | Populate only for ZED development USB build; DNP in final product
ZED-F9P | Development USB | Populate | R41 | 1 | 100k | Resistor | R_0402_1005Metric | Yageo | RC0402FR-07100KL | C60491 (https://www.lcsc.com/product-detail/C60491.html) | 1% |  | 0.063 W |  | 100k; 0402 unless footprint states otherwise; verify tolerance and power |  | 2026-09-20 | 8343600 |  | Populate only for ZED development USB build; DNP in final product
ZED-F9P | Development USB | Populate | U4 | 1 | AP2112K-3.3TRG1 | LDO Regulator | SOT_RG1_DIO_AP2112K | Diodes Incorporated | AP2112K-3.3TRG1 | C51118 (https://www.lcsc.com/product-detail/C51118.html) |  |  |  |  | Exact manufacturer ordering code and verified footprint | ${KIPRJMOD}/../datasheets/AP2112.pdf | 2026-09-20 | 52940 |  | Populate only for ZED development USB build; DNP in final product
ZED-F9P | Standard | Populate | C20 | 1 | 100nF | Murata GRM155R71C104JA88D, 100 nF, 5%, 16 V, X7R, 0402 | C_0402_1005Metric | Murata | GRM155R71C104JA88D | C913742 (https://www.lcsc.com/product-detail/C913742.html) | 5% | 16V |  | X7R | Use exact documented part unless engineering review approves a replacement |  | 2026-09-20 | 17050
ZED-F9P | Standard | Populate | C25 | 1 | 2.2uF | Unpolarized capacitor | C_0402_1005Metric | Murata | GRM155R61C225KE44D | C335109 (https://www.lcsc.com/product-detail/C335109.html) | 10% | 16V |  | X5R | 2uF; 16V; 10%; verify DC-bias derating |  | 2026-09-20 | 24100
ZED-F9P | Standard | Populate | C26 | 1 | 0.1uF | Unpolarized capacitor | C_0402_1005Metric | Murata | GRM155R71C104KA88D | C71629 (https://www.lcsc.com/product-detail/C71629.html) | 10% | 16V |  | X7R | 0.1uF; 16V; 10%; verify DC-bias derating |  | 2026-09-20 | 2302200
ZED-F9P | Standard | Populate | C27 | 1 | 1.0uF | Unpolarized capacitor | C_0402_1005Metric | Murata | GRM155R61C105KE01D | C77007 (https://www.lcsc.com/product-detail/C77007.html) | 10% | 16V |  | X5R | 1.0uF; 16V; 10%; verify DC-bias derating |  | 2026-09-20 | 279200
ZED-F9P | Standard | Populate | D4 | 1 | PESD0402-140 | 40V Clamp - Ipp Tvs Diode | DIO_PESD0402-140 | Littelfuse | PESD0402-140 | C10662 (https://www.lcsc.com/product-detail/C10662.html) |  |  |  |  | Exact manufacturer ordering code and verified footprint |  | 2026-09-20 | 73695
ZED-F9P | Standard | Populate | D5 | 1 | Yellow | Light emitting diode | LED_0402_1005Metric_Red | XINGLIGHT | XL-1005UYC | C25503856 (https://www.lcsc.com/product-detail/C25503856.html) |  |  |  |  |  |  | 2026-09-20 | 77500
ZED-F9P | Standard | Populate | D6 | 1 | GREEN | Light emitting diode | LED_0402_1005Metric_Red | XINGLIGHT | XL-1005UGC | C965793 (https://www.lcsc.com/product-detail/C965793.html) |  |  |  |  |  |  | 2026-09-20 | 1209750
ZED-F9P | Standard | Populate | D7 | 1 | BLUE | Light emitting diode | LED_0402_1005Metric_Red | XINGLIGHT | XL-1005UBC | C22355736 (https://www.lcsc.com/product-detail/C22355736.html) |  |  |  |  |  |  | 2026-09-20 | 267000
ZED-F9P | Standard | Populate | IC2 | 1 | ZED-F9P-05B | GNSS / GPS Modules High Precision Multi-band RTK GNSS module, with Galileo OSNMA | ZEDF9P05B | u-blox | ZED-F9P-05B | Mouser 134-ZED-F9P-05B |  |  |  |  | Exact manufacturer ordering code and verified footprint | https://www.u-blox.com/en/product/zed-f9p-module | 2026-09-21 | 791 | ZED-F9P-04B / LCSC C5120257 only after hardware, firmware, and feature revision review | APPROVED MOUSER SOURCE: 134-ZED-F9P-05B matches exact u-blox ZED-F9P-05B. LCSC C5120257 is -04B and is not approved as a substitute. | Mouser 134-ZED-F9P-05B
ZED-F9P | Standard | Populate | J3 | 1 | U.FL-R-SMT-1_10_ | U.FL (UMCC) Connector Receptacle, Male Pin 50 Ohms Surface Mount Solder | HRS_U.FL-R-SMT-1_10_ | Hirose | U.FL-R-SMT-1(10) | C88373 (https://www.lcsc.com/product-detail/C88373.html) |  |  |  |  | Exact manufacturer ordering code and verified footprint |  | 2026-09-20 | 8975
ZED-F9P | Standard | Populate | L3 | 1 | 47nH | Inductor, Murata LQG15H, LQW15A Series 47nH 5% | L_0402_1005Metric | Murata | LQG15HS47NJ02D | C97998 (https://www.lcsc.com/product-detail/C97998.html) |  |  |  |  | 47 nH, 5%, >=300 mA, >500 ohm impedance from 1-1.8 GHz, 0402; exact selected part |  | 2026-09-20 | 56050
ZED-F9P | Standard | Populate | R20, R22, R23, R24, R25, R26, R27, R31, R33, R36, R37 | 11 | 33 | Resistor | R_0402_1005Metric | Yageo | RC0402FR-0733RL | C138002 (https://www.lcsc.com/product-detail/C138002.html) | 1% |  | 0.063 W |  | 33; 0402 unless footprint states otherwise; verify tolerance and power |  | 2026-09-20 | 8094900
ZED-F9P | Standard | Populate | R21, R29, R30 | 3 | 1k | Resistor | R_0402_1005Metric | Yageo | RC0402FR-071KL | C106235 (https://www.lcsc.com/product-detail/C106235.html) | 1% |  | 0.063 W |  | 1k; 0402 unless footprint states otherwise; verify tolerance and power |  | 2026-09-20 | 2630200
ZED-F9P | Standard | DNP | R28 | 1 | 33 DNP | Resistor | R_0402_1005Metric | Yageo | RC0402FR-0733RL | C138002 (https://www.lcsc.com/product-detail/C138002.html) | 1% |  | 0.063 W |  | 33 DNP; 0402 unless footprint states otherwise; verify tolerance and power |  | 2026-09-20 | 8094900 |  | DNP by default; controlled recovery access only
ZED-F9P | Standard | Populate | R32 | 1 | 10 | Resistor | R_2010_5025Metric | Bourns | CMP2010-FX-10R0ELF | C1880468 (https://www.lcsc.com/product-detail/C1880468.html) | 1% | 200 V | 1 W at ambient <=70 degC; derate above 70 degC | Thick film, high-power anti-surge | 10 ohm; 1%; >=1 W; 2010; withstand active-antenna short-circuit current | ${KIPRJMOD}/../datasheets/Bourns_CMP.pdf | 2026-09-20 | 1595 |  | Approved and implemented selection for the ZED-F9P antenna-bias current limiter. LCSC identity, 10 ohm, 1%, 1 W, 2010 package, and availability verified 2026-09-20. The saved schematic and PCB use R_2010_5025Metric; placement and routing are complete, with zero unconnected items in the post-layout DRC.

Sheet: Raw KiCad BOM
Id | Designator | Footprint | Quantity | Designation | Supplier and ref
1 | C1, C18, C19 | C_0603_1608Metric | 3 | 10uF
2 | C2, C3, C7, C21, C22, C23, C24, C27, C28 | C_0402_1005Metric | 9 | 1.0uF
3 | C4, C17 | C_0603_1608Metric | 2 | 22uF
4 | C5, C6, C8, C9, C10, C11, C13, C14, C15, C26 | C_0402_1005Metric | 10 | 0.1uF
5 | C12 | C_0805_2012Metric | 1 | 2.2uF
6 | C16 | C_0402_1005Metric | 1 | 10nF X7R
7 | C20 | C_0402_1005Metric | 1 | 100nF X7R
8 | C25 | C_0402_1005Metric | 1 | 2uF
9 | D1 | LED_0402_1005Metric_Red | 1 | Blue
10 | D2, D4 | DIO_PESD0402-140 | 2 | PESD0402-140
11 | D3, D5 | LED_0402_1005Metric_Red | 2 | Yellow
12 | D6 | LED_0402_1005Metric_Red | 1 | GREEN
13 | D7 | LED_0402_1005Metric_Red | 1 | BLUE
14 | D8 | USBLC6-2SC6_SOT23-6L | 1 | USBLC6-2SC6
15 | G*** | OSHW-logo_silkscreen-back_4mm | 1 | OSHW-logo_silkscreen-back_4mm
16 | IC1 | MAXM10S00B | 1 | MAX-M10S-00B
17 | IC2 | ZEDF9P05B | 1 | ZED-F9P-05B
18 | J1 | PinHeader_1x18_P2.54mm_Vertical | 1 | Conn_01x18_Pin
19 | J2, J3 | HRS_U.FL-R-SMT-1_10_ | 2 | U.FL-R-SMT-1_10_
20 | J4 | USB4120-03-C_GCT | 1 | USB4120-03-C
21 | JP1 | Jumper_3_NO | 1 | ~
22 | JP2, JP7, JP9, JP10 | Jumper_2_NC_Trace | 4 | ~
23 | JP3 | Jumper_2_NO_NoSilk | 1 | LED ON
24 | JP4 | Jumper_2_NO | 1 | Enable Bias
25 | JP5, JP6, JP12, JP13 | Jumper_2_NO | 4 | Enable I2C
26 | JP8 | Jumper_2_NO | 1 | Jumper_2_Open
27 | JP11 | Jumper_2_NC_Trace | 1 | Enable Bias
28 | JP14 | Jumper_2_NO | 1 | USB omitted: ground V_USB
29 | L1 | IND_XFL4015_COC | 1 | XFL4015-471MEC
30 | L2 | L_0402_1005Metric | 1 | 27nH
31 | L3 | L_0402_1005Metric | 1 | 47nH
32 | R1, R2, R41 | R_0402_1005Metric | 3 | 100k
33 | R3, R4 | R_0402_1005Metric | 2 | 10
34 | R5 | R_0402_1005Metric | 1 | 604k
35 | R6 | R_0402_1005Metric | 1 | 91k
36 | R7, R8, R9, R10, R11, R13, R14, R20, R22, R23, R24, R25, R26, R27, R31, R33, R36, R37 | R_0402_1005Metric | 18 | 33
37 | R12 | R_0402_1005Metric | 1 | DNP (33)
38 | R15, R17 | R_0402_1005Metric | 2 | 2.2k
39 | R16 | R_0402_1005Metric | 1 | 1k
40 | R18, R21, R29, R30 | R_0402_1005Metric | 4 | 1k
41 | R28 | R_0402_1005Metric | 1 | 33 DNP
42 | R32, R40 | R_1210_3225Metric | 2 | 10
43 | R34, R35 | R_0402_1005Metric | 2 | 5.1k
44 | R38, R39 | R_0402_1005Metric | 2 | 27
45 | TP1, TP2, TP3, TP4, TP5, TP6, TP7, TP8 | TestPoint-1.0mm | 8 | 1.0mm
46 | U1 | DLA0010A | 1 | TPS63802DLAR
47 | U2 | WDFN6_2X2_ONS_NCV8705 | 1 | NCV8705MT33TCG
48 | U3 | SOT95P237X112-3N_MCP1700 | 1 | MCP1700T-3002E_TT
49 | U4 | SOT_RG1_DIO_AP2112K | 1 | AP2112K-3.3TRG1
50 | U5 | BGA9_BMM350_BOS | 1 | BMM350
51 | U6 | QFN10_BMP581_BOS | 1 | BMP581
52 | U7 | BMI323_BOS | 1 | BMI323
53 | U8 | SOT95P237X112-3N_MCP1700_1802 | 1 | MCP1700T-1802E/TT
