MediBrick/IMU_Brick/v2/KiCAD/reports/freeze-2026-09-19/VALIDATION.md

# Activity Brick V2 design freeze validation — 2026-09-19

This checkpoint covers the KiCad source files listed in `SHA256SUMS`. The
before/after manifests are identical, confirming that ERC and DRC did not alter
the checked source files.

## Results

- PCB DRC: **pass** — 0 violations, 0 unconnected pads, 0 footprint errors.
- Schematic ERC: **0 errors and 13 warnings**.
- Source stability: **pass** — `SHA256SUMS.before` and `SHA256SUMS.after` are
  identical.

The 13 ERC messages are pin-type warnings involving custom or third-party
symbols whose pins are typed `Unspecified`, intentional sensor address straps
connected to ground/PWR_FLAG, and passive connections. They are retained in
`ERC.rpt` for traceability. They do not indicate an open net or an ERC error,
but their electrical intent must remain part of the release review if the
symbols or associated nets change.

## Files

- `ERC.rpt` — complete KiCad ERC report
- `ERC_WARNING_REVIEW.md` — itemized disposition for all 13 ERC warnings
- `DRC.rpt` — complete KiCad DRC report
- `PARITY.md` — schematic-reference, numbered-pin/pad, and net-parity report
- `LAYOUT_REVIEW.md` — ratsnest, copper-zone, return-path, thermal, and
  board-perimeter review
- `SHA256SUMS.before` — source hashes captured before validation
- `SHA256SUMS.after` — source hashes captured after validation
- `SHA256SUMS` — frozen checkpoint manifest

This checkpoint freezes the electrical-design files for review. The production
release remains incomplete until the final BOM, assembly variants, placement
files, fabrication outputs, and manual release checklist are finished.
