MediBrick/IMU_Brick/v2/KiCAD/Activity_Brick.kicad_pcb

## KiCad design v2/KiCAD/Activity_Brick.kicad_pcb (2026-11-02)

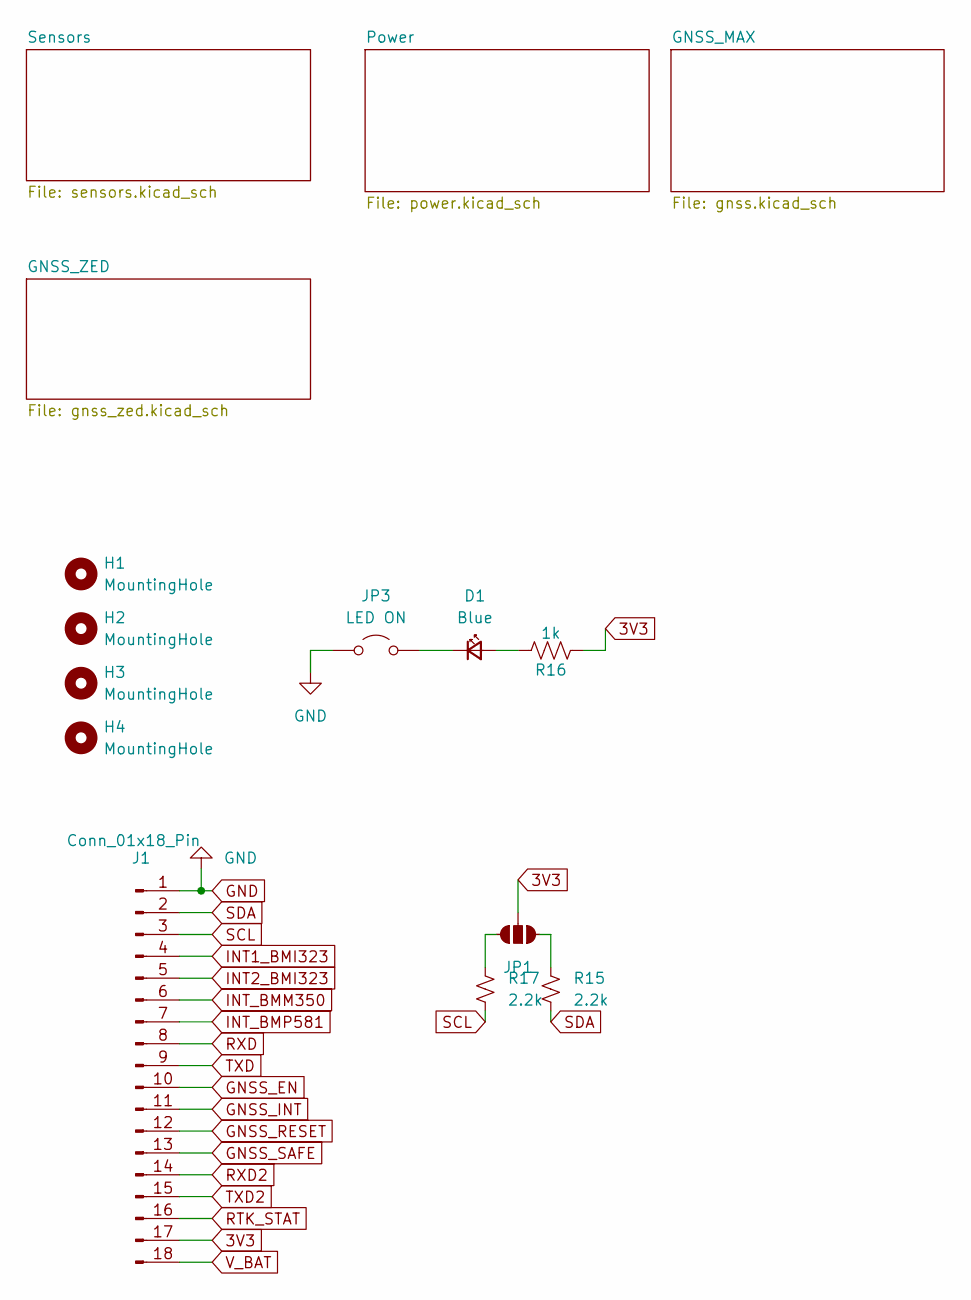
[picture p14: schematic Activity_Brick.kicad_sch, Activity Brick]

Parts:
D1: Blue; LED_0402_1005Metric_Red
H1, H2, H3, H4: MountingHole; MountingHole_3.5mm
J1: Conn_01x18_Pin; PinHeader_1x18_P2.54mm_Vertical
JP1: Jumper_3_NO
JP3: LED ON; Jumper_2_NO_NoSilk
R15, R17: 2.2k; R_0402_1005Metric
R16: 1k; R_0402_1005Metric

Connections:
3V3: J1.17, JP1.2 (B), R16.2; also elsewhere on the board
GND: J1.1, JP3.1 (A); also elsewhere on the board
GNSS_EN: J1.10; also elsewhere on the board
GNSS_INT: J1.11; also elsewhere on the board
GNSS_RESET: J1.12; also elsewhere on the board
GNSS_SAFE: J1.13; also elsewhere on the board
INT1_BMI323: J1.4; also elsewhere on the board
INT2_BMI323: J1.5; also elsewhere on the board
INT_BMM350: J1.6; also elsewhere on the board
INT_BMP581: J1.7; also elsewhere on the board
unnamed: D1.2 (A), R16.1
unnamed: D1.1 (K), JP3.2 (B)
unnamed: JP1.1 (A), R15.1
unnamed: JP1.3 (C), R17.1
RTK_STAT: J1.16; also elsewhere on the board
RXD: J1.8; also elsewhere on the board
RXD2: J1.14; also elsewhere on the board
SCL: J1.3, R17.2; also elsewhere on the board
SDA: J1.2, R15.2; also elsewhere on the board
TXD: J1.9; also elsewhere on the board
TXD2: J1.15; also elsewhere on the board
V_BAT: J1.18; also elsewhere on the board

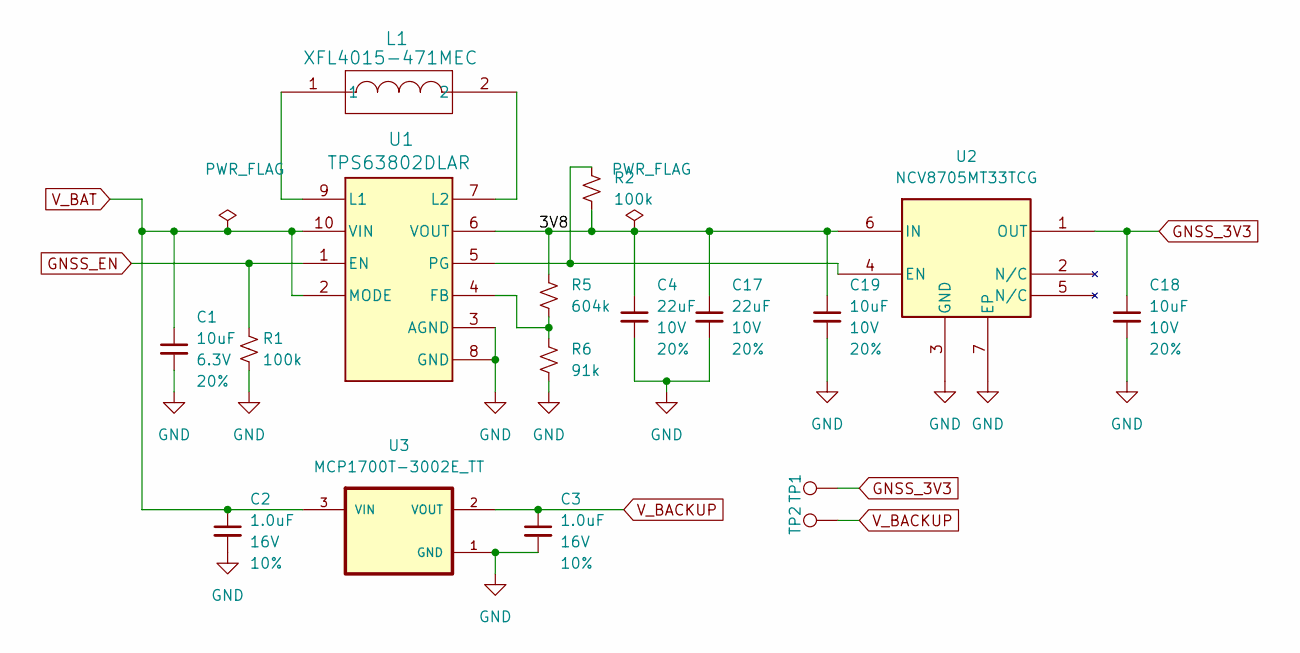
[picture p15: schematic power.kicad_sch, Activity Brick - GNSS Power]

Parts:
C1: 10uF; C_0603_1608Metric; Voltage 6.3V; Tolerance 20%
C2, C3: 1.0uF; C_0402_1005Metric; Voltage 16V; Tolerance 10%
C4, C17: 22uF; C_0603_1608Metric; Voltage 10V; Tolerance 20%
C18, C19: 10uF; C_0603_1608Metric; Voltage 10V; Tolerance 20%
L1: XFL4015-471MEC; IND_XFL4015_COC
R1, R2: 100k; R_0402_1005Metric
R5: 604k; R_0402_1005Metric
R6: 91k; R_0402_1005Metric
TP1, TP2: 1.0mm; TestPoint-1.0mm
U1: TPS63802DLAR; DLA0010A
U2: NCV8705MT33TCG; WDFN6_2X2_ONS_NCV8705
U3: MCP1700T-3002E_TT; SOT95P237X112-3N_MCP1700

Connections:
/Power/3V8: C4.1, C17.1, C19.1, R2.2, R5.2, U1.6 (VOUT), U2.6 (IN)
GND: C1.2, C2.2, C3.2, C4.2, C17.2, C18.2, C19.2, R1.2, R6.1, U1.3 (AGND), U1.8 (GND), U2.3 (GND), U2.7 (EP), U3.1 (GND); also elsewhere on the board
GNSS_3V3: C18.1, TP1.1 (1_1), U2.1 (OUT); also elsewhere on the board
GNSS_EN: R1.1, U1.1 (EN); also elsewhere on the board
unnamed: R5.1, R6.2, U1.4 (FB)
unnamed: L1.1, U1.9 (L1)
unnamed: L1.2, U1.7 (L2)
unnamed: R2.1, U1.5 (PG), U2.4 (EN)
V_BACKUP: C3.1, TP2.1 (1_1), U3.2 (VOUT); also elsewhere on the board
V_BAT: C1.1, C2.1, U1.2 (MODE), U1.10 (VIN), U3.3 (VIN); also elsewhere on the board

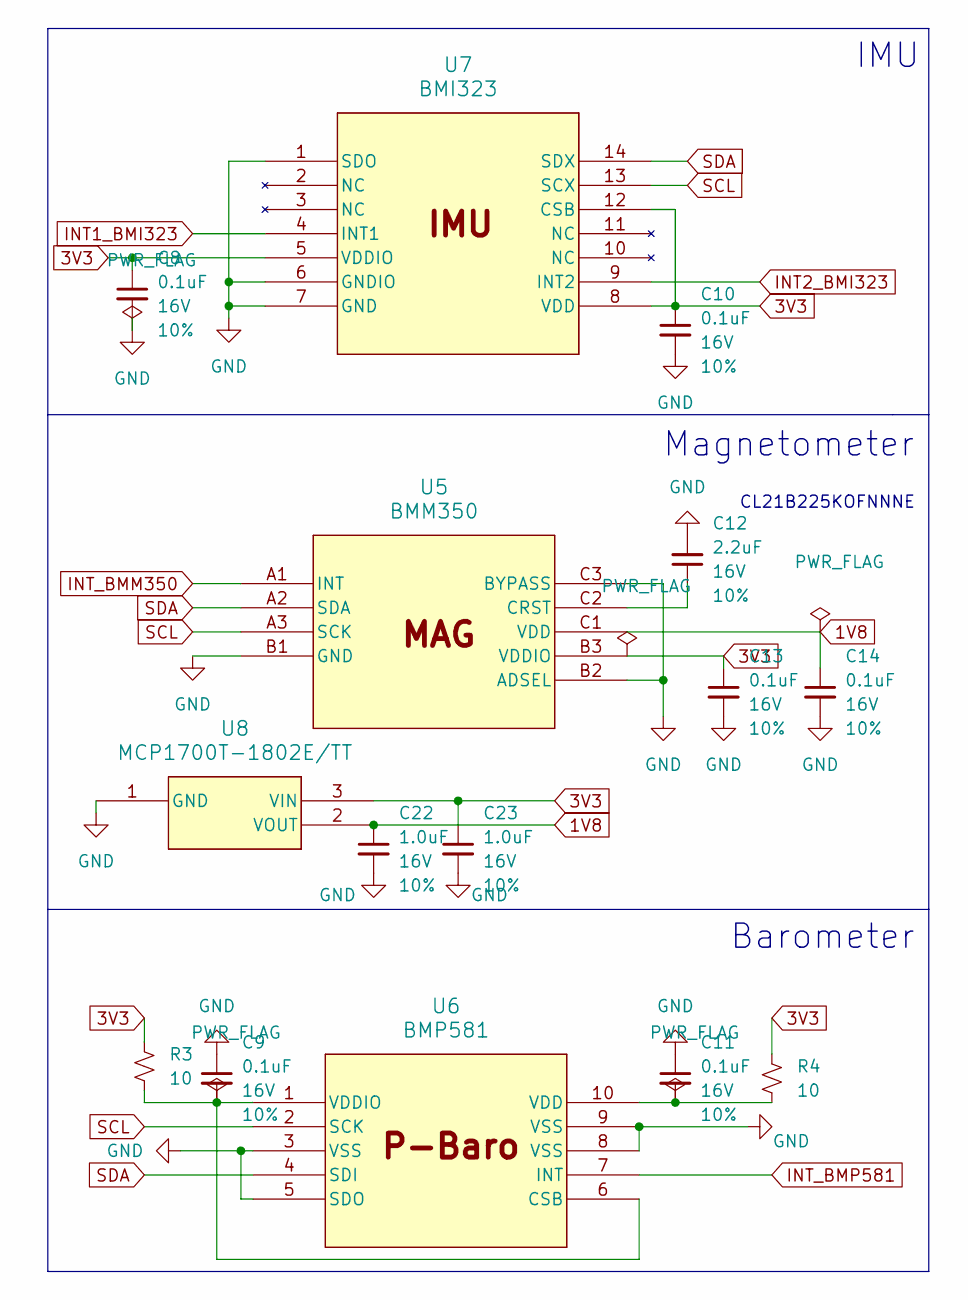
[picture p16: schematic sensors.kicad_sch, Activity Brick - Sensors]

Parts:
C8, C9, C10, C11, C13, C14: 0.1uF; C_0402_1005Metric; Voltage 16V; Tolerance 10%
C12: 2.2uF; C_0805_2012Metric; Voltage 16V; Tolerance 10%; MPN CL21B225KOFNNNE
C22, C23: 1.0uF; C_0402_1005Metric; Voltage 16V; Tolerance 10%
R3, R4: 10; R_0402_1005Metric
U5: BMM350; BGA9_BMM350_BOS
U6: BMP581; QFN10_BMP581_BOS
U7: BMI323; BMI323_BOS
U8: MCP1700T-1802E/TT; SOT95P237X112-3N_MCP1700_1802

Connections:
1V8: C14.1, C22.1, U5.C1 (VDD), U8.2 (VOUT)
3V3: C8.1, C10.1, C13.1, C23.1, R3.2, R4.2, U5.B3 (VDDIO), U7.5 (VDDIO), U7.8 (VDD), U7.12 (CSB), U8.3 (VIN); also elsewhere on the board
GND: C8.2, C9.1, C10.2, C11.1, C12.2, C13.2, C14.2, C22.2, C23.2, U5.B1 (GND), U5.B2 (ADSEL), U5.C3 (BYPASS), U6.3 (VSS), U6.5 (SDO), U6.8 (VSS), U6.9 (VSS), U7.1 (SDO), U7.6 (GNDIO), U7.7 (GND), U8.1 (GND); also elsewhere on the board
INT1_BMI323: U7.4 (INT1); also elsewhere on the board
INT2_BMI323: U7.9 (INT2); also elsewhere on the board
INT_BMM350: U5.A1 (INT); also elsewhere on the board
INT_BMP581: U6.7 (INT); also elsewhere on the board
unnamed: C12.1, U5.C2 (CRST)
unnamed: C9.2, R3.1, U6.1 (VDDIO), U6.6 (CSB)
unnamed: C11.2, R4.1, U6.10 (VDD)
SCL: U5.A3 (SCK), U6.2 (SCK), U7.13 (SCX); also elsewhere on the board
SDA: U5.A2 (SDA), U6.4 (SDI), U7.14 (SDX); also elsewhere on the board

Notes on the sheet:
Magnetometer
CL21B225KOFNNNE
IMU
Barometer

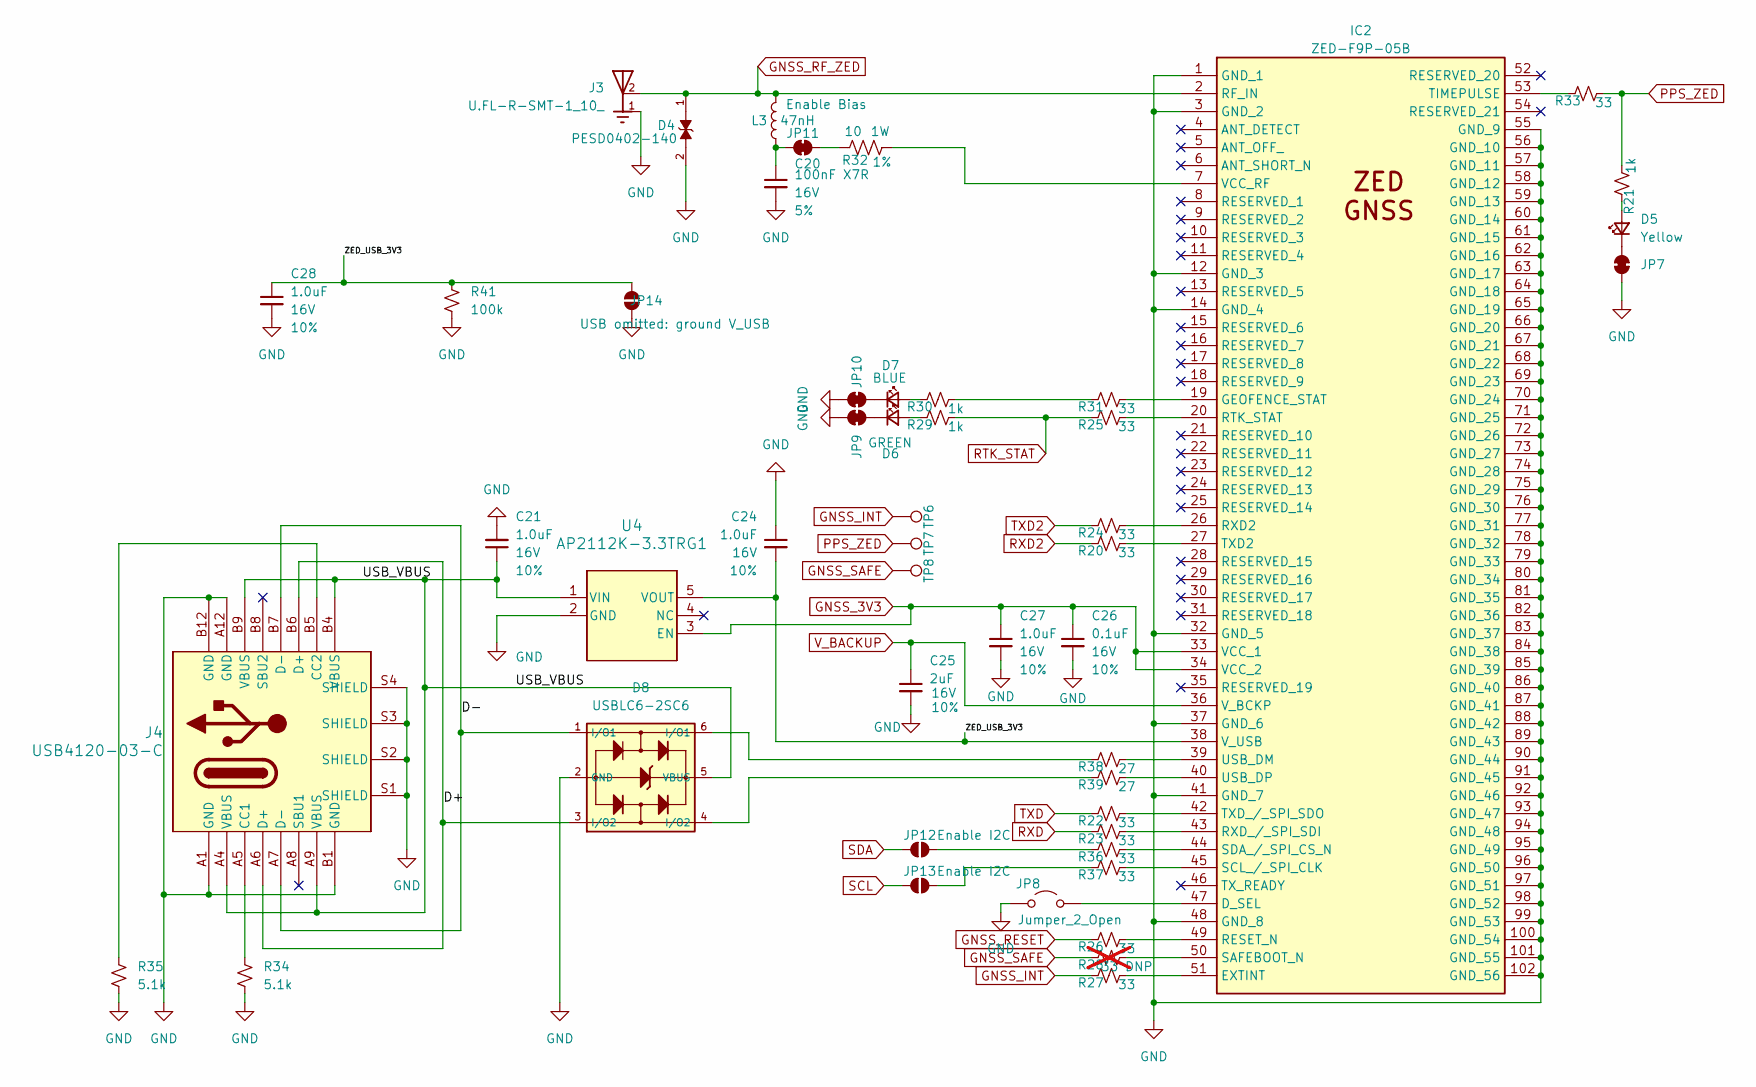
[picture p17: schematic gnss_zed.kicad_sch, Activity Brick - ZED RTK GPS]

Parts:
C20: 100nF X7R; C_0402_1005Metric; Voltage 16V; Tolerance 5%; Part Murata GRM155R71C104JA88D
C21, C24, C27, C28: 1.0uF; C_0402_1005Metric; Voltage 16V; Tolerance 10%
C25: 2uF; C_0402_1005Metric; Voltage 16V; Tolerance 10%
C26: 0.1uF; C_0402_1005Metric; Voltage 16V; Tolerance 10%
D4: PESD0402-140; DIO_PESD0402-140; PARTREV 2016
D5: Yellow; LED_0402_1005Metric_Red
D6: GREEN; LED_0402_1005Metric_Red
D7: BLUE; LED_0402_1005Metric_Red
D8: USBLC6-2SC6; USBLC6-2SC6_SOT23-6L
IC2: ZED-F9P-05B; ZEDF9P05B; Manufacturer_Part_Number ZED-F9P-05B; Mouser Part Number 134-ZED-F9P-05B
J3: U.FL-R-SMT-1_10_; HRS_U.FL-R-SMT-1_10_
J4: USB4120-03-C; USB4120-03-C_GCT
JP7, JP9, JP10: Jumper_2_NC_Trace
JP8: Jumper_2_Open; Jumper_2_NO
JP11: Enable Bias; Jumper_2_NC_Trace
JP12, JP13: Enable I2C; Jumper_2_NO
JP14: USB omitted: ground V_USB; Jumper_2_NO
L3: 47nH; L_0402_1005Metric; Part Murata LQG15HS47NJ02D
R20, R22, R23, R24, R25, R26, R27, R31, R33, R36, R37: 33; R_0402_1005Metric
R21, R29, R30: 1k; R_0402_1005Metric
R28: 33 DNP; R_0402_1005Metric; not fitted
R32: 10; R_2010_5025Metric; Tolerance 1%; Part Bourns CMP2010-FX-10R0ELF
R34, R35: 5.1k; R_0402_1005Metric
R38, R39: 27; R_0402_1005Metric
R41: 100k; R_0402_1005Metric
TP6, TP7, TP8: 1.0mm; TestPoint-1.0mm
U4: AP2112K-3.3TRG1; SOT_RG1_DIO_AP2112K

Connections:
/GNSS_ZED/D+: D8.3 (I/O2), J4.A6 (D+), J4.B6 (D+)
/GNSS_ZED/D-: D8.1 (I/O1), J4.A7 (D-), J4.B7 (D-)
/GNSS_ZED/USB_VBUS: C21.1, D8.5 (VBUS), J4.A4 (VBUS), J4.A9 (VBUS), J4.B4 (VBUS), J4.B9 (VBUS), U4.1 (VIN)
/GNSS_ZED/ZED_USB_3V3: C24.2, C28.1, IC2.38 (V_USB), JP14.2 (B), R41.2, U4.5 (VOUT)
GND: C20.2, C21.2, C24.1, C25.2, C26.2, C27.2, C28.2, D4.2, D8.2 (GND), IC2.1 (GND_1), IC2.3 (GND_2), IC2.12 (GND_3), IC2.14 (GND_4), IC2.32 (GND_5), IC2.37 (GND_6), IC2.41 (GND_7), IC2.48 (GND_8), IC2.55 (GND_9), IC2.56 (GND_10), IC2.57 (GND_11), IC2.58 (GND_12), IC2.59 (GND_13), IC2.60 (GND_14), IC2.61 (GND_15), IC2.62 (GND_16), IC2.63 (GND_17), IC2.64 (GND_18), IC2.65 (GND_19), IC2.66 (GND_20), IC2.67 (GND_21), IC2.68 (GND_22), IC2.69 (GND_23), IC2.70 (GND_24), IC2.71 (GND_25), IC2.72 (GND_26), IC2.73 (GND_27), IC2.74 (GND_28), IC2.75 (GND_29), IC2.76 (GND_30), IC2.77 (GND_31), IC2.78 (GND_32), IC2.79 (GND_33), IC2.80 (GND_34), IC2.81 (GND_35), IC2.82 (GND_36), IC2.83 (GND_37), IC2.84 (GND_38), IC2.85 (GND_39), IC2.86 (GND_40), IC2.87 (GND_41), IC2.88 (GND_42), IC2.89 (GND_43), IC2.90 (GND_44), IC2.91 (GND_45), IC2.92 (GND_46), IC2.93 (GND_47), IC2.94 (GND_48), IC2.95 (GND_49), IC2.96 (GND_50), IC2.97 (GND_51), IC2.98 (GND_52), IC2.99 (GND_53), IC2.100 (GND_54), IC2.101 (GND_55), IC2.102 (GND_56), J3.1, J3.3, J4.A1 (GND), J4.A12 (GND), J4.B1 (GND), J4.B12 (GND), J4.S1 (SHIELD), J4.S2 (SHIELD), J4.S3 (SHIELD), J4.S4 (SHIELD), JP7.1 (A), JP8.1 (A), JP9.1 (A), JP10.1 (A), JP14.1 (A), R34.1, R35.1, R41.1, U4.2 (GND); also elsewhere on the board
GNSS_3V3: C26.1, C27.1, IC2.33 (VCC_1), IC2.34 (VCC_2), U4.3 (EN); also elsewhere on the board
GNSS_INT: R27.1, TP6.1 (1_1); also elsewhere on the board
GNSS_RESET: R26.1; also elsewhere on the board
GNSS_RF_ZED: D4.1, IC2.2 (RF_IN), J3.2, L3.2
GNSS_SAFE: R28.1, TP8.1 (1_1); also elsewhere on the board
unnamed: D5.2 (A), R21.1
unnamed: D5.1 (K), JP7.2 (B)
unnamed: D6.2 (A), R29.1
unnamed: D6.1 (K), JP9.2 (B)
unnamed: D7.2 (A), R30.1
unnamed: D7.1 (K), JP10.2 (B)
unnamed: D8.6 (I/O1), R38.1
unnamed: D8.4 (I/O2), R39.1
unnamed: IC2.47 (D_SEL), JP8.2 (B)
unnamed: IC2.51 (EXTINT), R27.2
unnamed: IC2.19 (GEOFENCE_STAT), R31.2
unnamed: IC2.49 (RESET_N), R26.2
unnamed: IC2.20 (RTK_STAT), R25.2
unnamed: IC2.26 (RXD2), R24.2
unnamed: IC2.43 (RXD_/_SPI_SDI), R23.2
unnamed: IC2.50 (SAFEBOOT_N), R28.2
unnamed: IC2.45 (SCL_/_SPI_CLK), R37.2
unnamed: IC2.44 (SDA_/_SPI_CS_N), R36.2
unnamed: IC2.53 (TIMEPULSE), R33.1
unnamed: IC2.27 (TXD2), R20.2
unnamed: IC2.42 (TXD_/_SPI_SDO), R22.2
unnamed: IC2.39 (USB_DM), R38.2
unnamed: IC2.40 (USB_DP), R39.2
unnamed: IC2.7 (VCC_RF), R32.2
unnamed: J4.A5 (CC1), R34.2
unnamed: J4.B5 (CC2), R35.2
unnamed: C20.1, JP11.1 (A), L3.1
unnamed: JP11.2 (B), R32.1
unnamed: JP12.2 (B), R36.1
unnamed: JP13.2 (B), R37.1
unnamed: R30.2, R31.1
PPS_ZED: R21.2, R33.2, TP7.1 (1_1)
RTK_STAT: R25.1, R29.2; also elsewhere on the board
RXD: R23.1; also elsewhere on the board
RXD2: R20.1; also elsewhere on the board
SCL: JP13.1 (A); also elsewhere on the board
SDA: JP12.1 (A); also elsewhere on the board
TXD: R22.1; also elsewhere on the board
TXD2: R24.1; also elsewhere on the board
V_BACKUP: C25.1, IC2.36 (V_BCKP); also elsewhere on the board

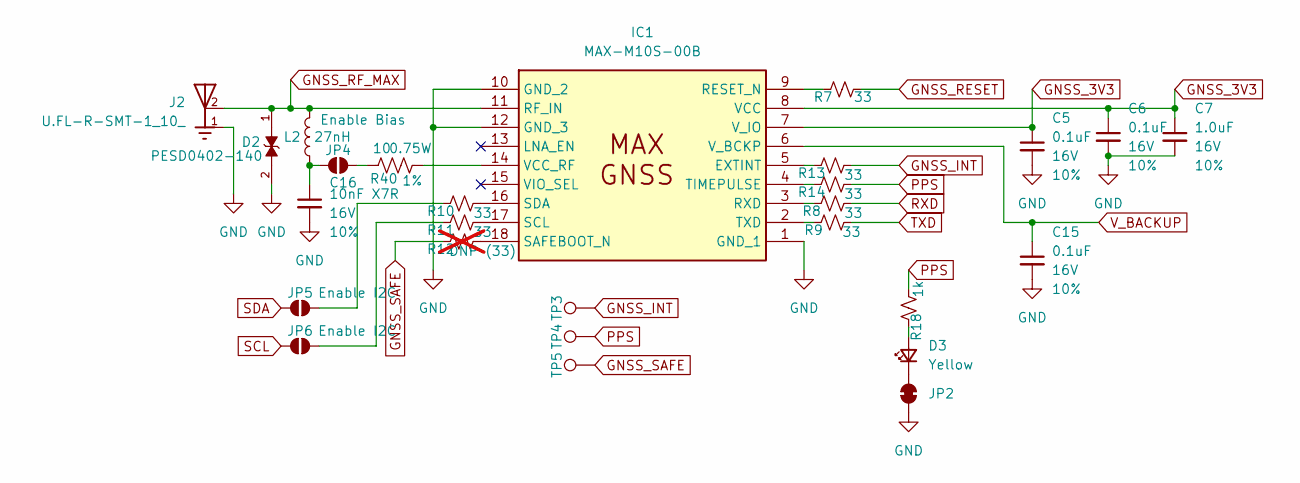
[picture p18: schematic gnss.kicad_sch, Activity Brick - GPS MAX]

Parts:
C5, C6, C15: 0.1uF; C_0402_1005Metric; Voltage 16V; Tolerance 10%
C7: 1.0uF; C_0402_1005Metric; Voltage 16V; Tolerance 10%
C16: 10nF X7R; C_0402_1005Metric; Voltage 16V; Tolerance 10%
D2: PESD0402-140; DIO_PESD0402-140; PARTREV 2016
D3: Yellow; LED_0402_1005Metric_Red
IC1: MAX-M10S-00B; MAXM10S00B; Manufacturer_Part_Number MAX-M10S-00B; Mouser Part Number 377-MAX-M10S-00B
J2: U.FL-R-SMT-1_10_; HRS_U.FL-R-SMT-1_10_
JP2: Jumper_2_NC_Trace
JP4: Enable Bias; Jumper_2_NO
JP5, JP6: Enable I2C; Jumper_2_NO
L2: 27nH; L_0402_1005Metric; Part Murata `LQG15HN27NH02D`
R7, R8, R9, R10, R11, R13, R14: 33; R_0402_1005Metric
R12: DNP (33); R_0402_1005Metric; not fitted
R18: 1k; R_0402_1005Metric
R40: 10; R_1210_3225Metric; Tolerance 1%; Part VISHAY CRCW121010R0FKEAHP 0.75W 1210
TP3, TP4, TP5: 1.0mm; TestPoint-1.0mm

Connections:
GND: C5.2, C6.2, C7.2, C15.2, C16.2, D2.2, IC1.1 (GND_1), IC1.10 (GND_2), IC1.12 (GND_3), J2.1, J2.3, JP2.1 (A); also elsewhere on the board
GNSS_3V3: C5.1, C6.1, C7.1, IC1.7 (V_IO), IC1.8 (VCC); also elsewhere on the board
GNSS_INT: R13.2, TP3.1 (1_1); also elsewhere on the board
GNSS_RESET: R7.2; also elsewhere on the board
GNSS_RF_MAX: D2.1, IC1.11 (RF_IN), J2.2, L2.2
GNSS_SAFE: R12.1, TP5.1 (1_1); also elsewhere on the board
unnamed: D3.2 (A), R18.1
unnamed: D3.1 (K), JP2.2 (B)
unnamed: IC1.5 (EXTINT), R13.1
unnamed: IC1.9 (RESET_N), R7.1
unnamed: IC1.3 (RXD), R8.1
unnamed: IC1.18 (SAFEBOOT_N), R12.2
unnamed: IC1.17 (SCL), R11.2
unnamed: IC1.16 (SDA), R10.2
unnamed: IC1.4 (TIMEPULSE), R14.1
unnamed: IC1.2 (TXD), R9.1
unnamed: IC1.14 (VCC_RF), R40.2
unnamed: C16.1, JP4.1 (A), L2.1
unnamed: JP4.2 (B), R40.1
unnamed: JP5.2 (B), R10.1
unnamed: JP6.2 (B), R11.1
PPS: R14.2, R18.2, TP4.1 (1_1)
RXD: R8.2; also elsewhere on the board
SCL: JP6.1 (A); also elsewhere on the board
SDA: JP5.1 (A); also elsewhere on the board
TXD: R9.2; also elsewhere on the board
V_BACKUP: C15.1, IC1.6 (V_BCKP); also elsewhere on the board

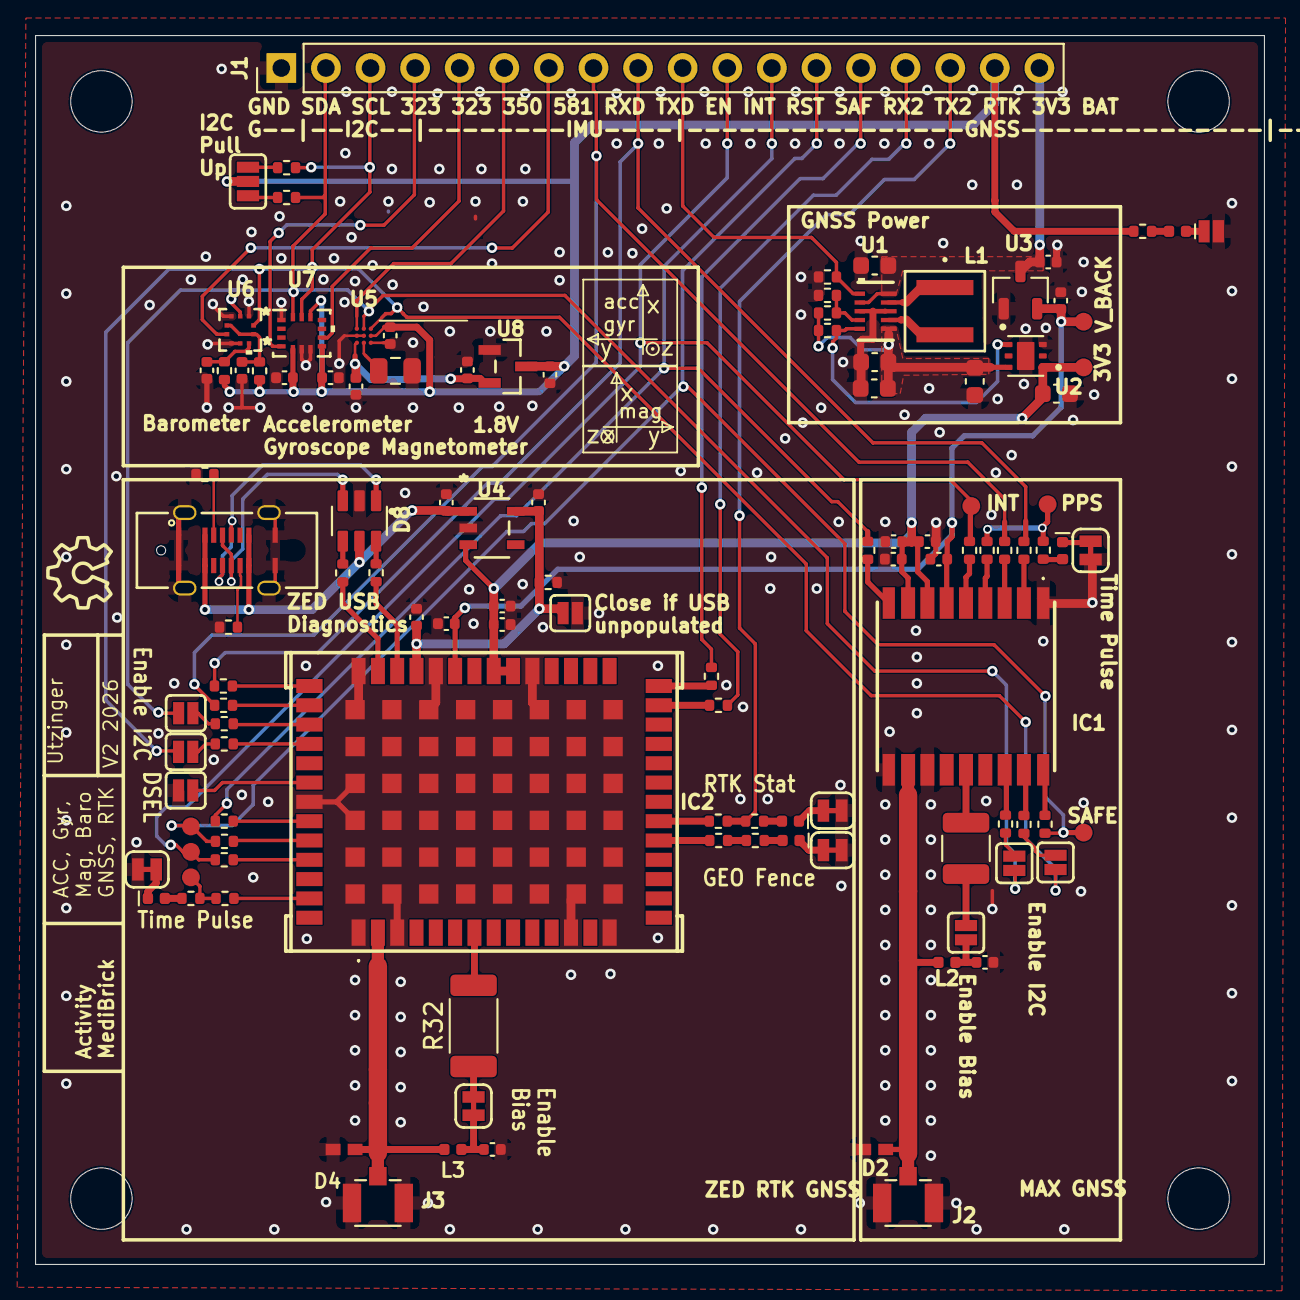
[picture p19: board Activity_Brick.kicad_pcb from above]

Board: 2 copper layers, 70.0 x 70.0 mm, 120 parts (0 on the bottom side), 87 nets.

Other parts of the board:
G1: OSHW_Logo; Creative_Commons_License
