MediBrick/IMU_Brick/v1/IMU.brd

## EAGLE design v1/IMU.brd (2025-12-08, an earlier design)

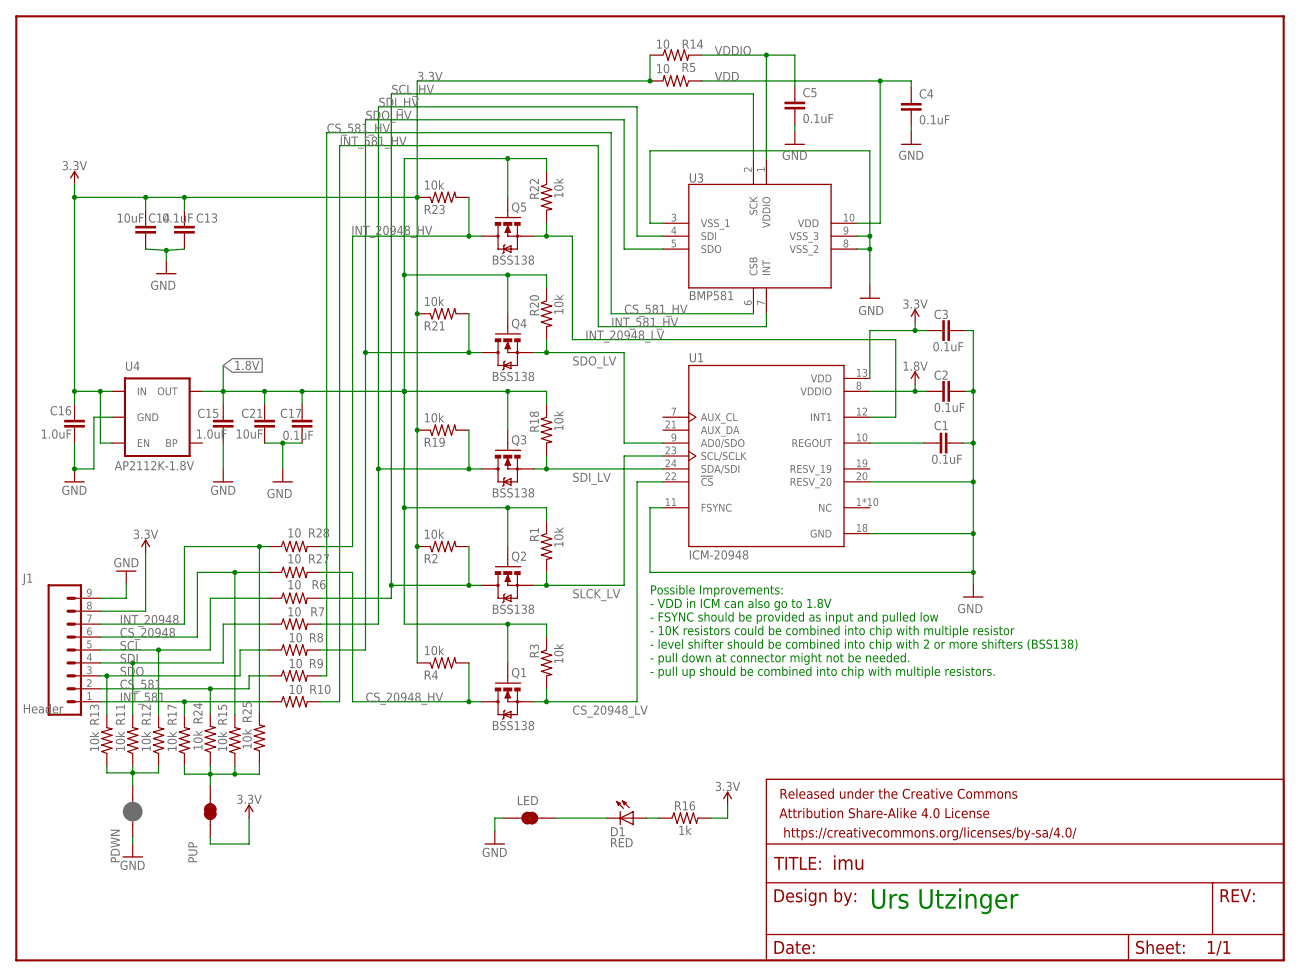
[picture p20: schematic IMU.sch]

Parts:
C1, C2, C3, C4, C5, C13, C17: 0.1uF; 0603
C14, C21: 10uF; 0603@1
C15, C16: 1.0uF; 0603
D1: RED; LED-0603
FRAME1: FRAME-LETTERNO_PACKAGE; DUMMY
J1: Header; 1X09
LED: LED ENABLE; SMT-JUMPER_2_NC_TRACE_SILK
PDWN: JUMPER-SMT_2_NC_PASTE_SILK; SMT-JUMPER_2_NC_PASTE_SILK
PUP: JUMPER-SMT_2_NC_TRACE_SILK; SMT-JUMPER_2_NC_TRACE_SILK
Q1, Q2, Q3, Q4, Q5: BSS138; SPARKFUN_SOT23-3
R1, R2, R3, R4, R11, R12, R13, R15, R17, R18, R19, R20, R21, R22, R23, R24, R25: 10k; 0603
R5, R6, R7, R8, R9, R10, R14, R27, R28: 10; 0603
R16: 1k; 0603
U1: ICM-20948; QFN40P300X300X105-24N
U3: BMP581
U4: AP2112K-1.8V; SPARKFUN-POWERIC_SOT23-5

Connections:
1.8V: C2.1, C15.2, C17.1, C21.1, Q1.1 (G), Q2.1 (G), Q3.1 (G), Q4.1 (G), Q5.1 (G), R1.1, R3.1, R18.1, R20.1, R22.1, U1.8 (VDDIO), U4.5 (OUT)
3.3V: C3.1, C13.1, C14.1, C16.2, J1.8, PUP.1, R2.1, R4.1, R5.2, R14.1, R16.2, R19.1, R21.1, R23.1, U1.13 (VDD), U4.1 (IN), U4.3 (EN)
CS_581: J1.2, R9.1, R24.2
CS_581_HV: R9.2, U3.6 (CSB)
CS_20948: J1.6, R15.2, R27.1
CS_20948_HV: Q1.3 (D), R4.2, R27.2
CS_20948_LV: Q1.2 (S), R3.2, U1.22 (!CS)
GND: C1.2, C2.2, C3.2, C4.2, C5.2, C13.2, C14.2, C15.1, C16.1, C17.2, C21.2, J1.9, LED.1, PDWN.1, U1.11 (FSYNC), U1.18 (GND), U1.20 (RESV_20), U3.3 (VSS_1), U3.8 (VSS_2), U3.9 (VSS_3), U4.2 (GND)
INT_581: J1.1, R10.1, R17.2
INT_581_HV: R10.2, U3.7 (INT)
INT_20948: J1.7, R25.2, R28.1
INT_20948_HV: Q5.3 (D), R23.2, R28.2
INT_20948_LV: Q5.2 (S), R22.2, U1.12 (INT1)
unnamed: C1.1, U1.10 (REGOUT)
unnamed: D1.A, R16.1
unnamed: D1.C, LED.2
unnamed: PDWN.2, R11.1, R12.1, R13.1
unnamed: PUP.2, R15.1, R17.1, R24.1, R25.1
SCL: J1.5, R6.1, R12.2
SCL_HV: Q2.3 (D), R2.2, R6.2, U3.2 (SCK)
SDI: J1.4, R7.1, R11.2
SDI_HV: Q3.3 (D), R7.2, R19.2, U3.4 (SDI)
SDI_LV: Q3.2 (S), R18.2, U1.24 (SDA/SDI)
SDO: J1.3, R8.1, R13.2
SDO_HV: Q4.3 (D), R8.2, R21.2, U3.5 (SDO)
SDO_LV: Q4.2 (S), R20.2, U1.9 (AD0/SDO)
SLCK_LV: Q2.2 (S), R1.2, U1.23 (SCL/SCLK)
VDD: C4.1, R5.1, U3.10 (VDD)
VDDIO: C5.1, R14.2, U3.1 (VDDIO)

Notes on the sheet:
Urs Utzinger
Possible Improvements: - VDD in ICM can also go to 1.8V - FSYNC should be provided as input and pulled low - 10K resistors could be combined into chip with multiple resistor - level shifter should be combined into chip with 2 or more shifters (BSS138) - pull down at connector might not be needed. -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

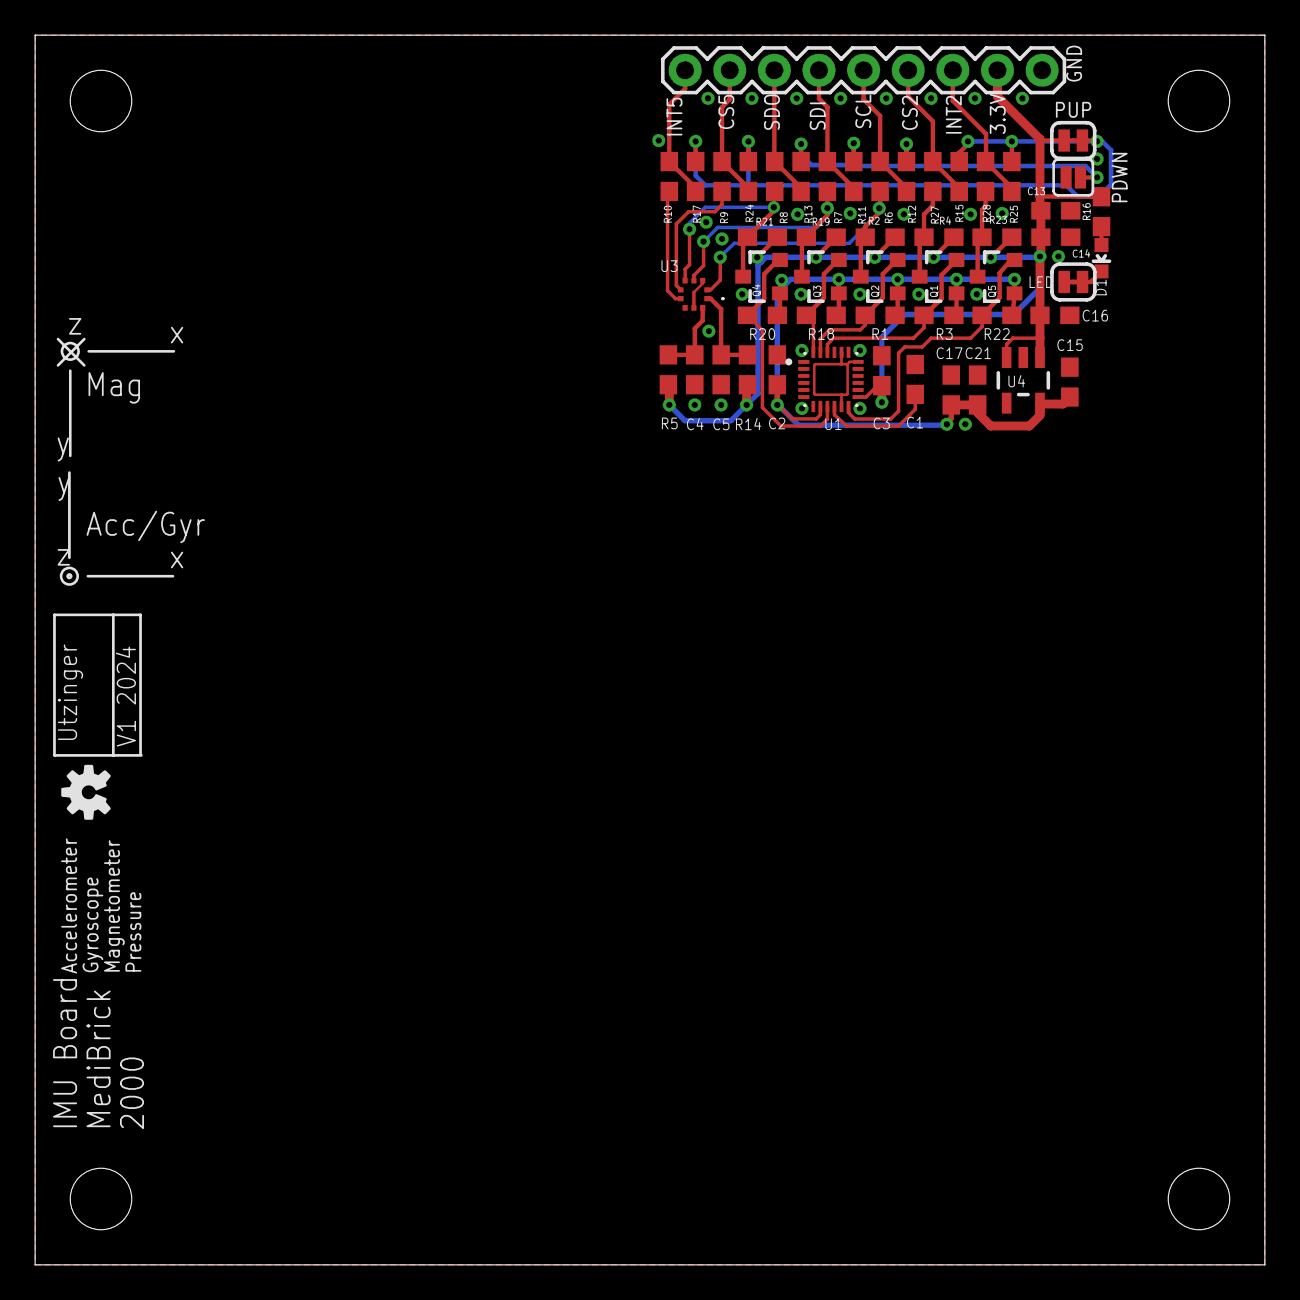
[picture p21: board IMU.brd from above]

Board: 2 copper layers, 70.0 x 70.0 mm, 53 parts (0 on the bottom side), 29 nets.

Other parts of the board:
U$1: OSHW-LOGO-S
