MediBrick/IMU_Brick/v2/KiCAD/design_blocks/ActivityBrick.kicad_blocks/GNSS_MAX_M10S.kicad_block/GNSS_MAX_M10S.kicad_sch

## KiCad design v2/KiCAD/design_blocks/ActivityBrick.kicad_blocks/GNSS_MAX_M10S.kicad_block/GNSS_MAX_M10S.kicad_sch (2026-11-02)

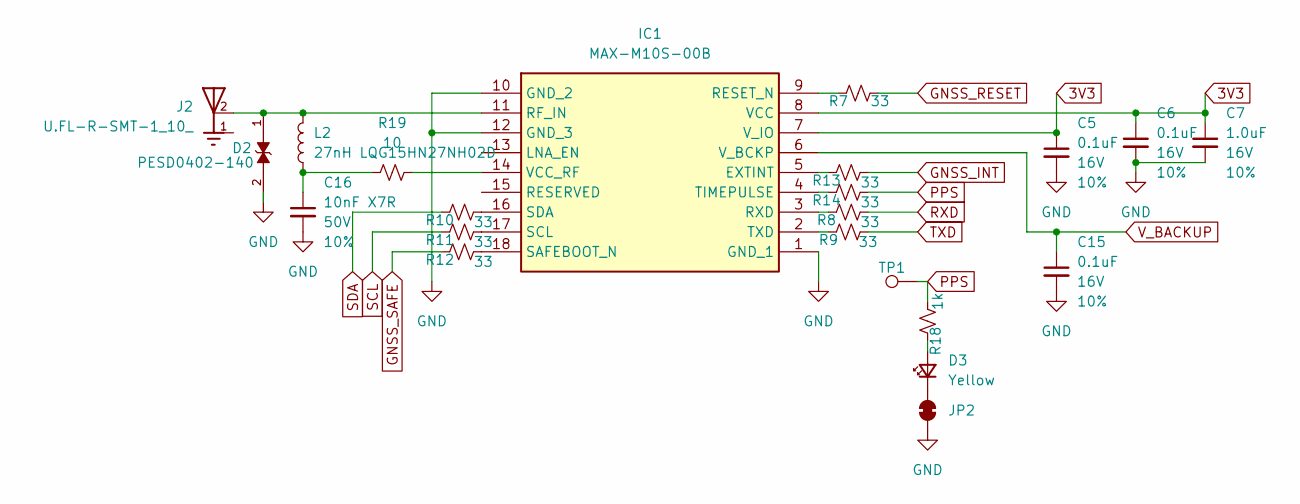
[picture p22: schematic GNSS_MAX_M10S.kicad_sch]

Parts:
C5, C6, C15: 0.1uF; C_0402_1005Metric; Voltage 16V; Tolerance 10%
C7: 1.0uF; C_0402_1005Metric; Voltage 16V; Tolerance 10%
C16: 10nF X7R; C_0402_1005Metric; Voltage 50V; Tolerance 10%; MPN GRM155R71C103KA01J
D2: PESD0402-140; DIO_PESD0402-140; PARTREV 2016
D3: Yellow; LED_0402_1005Metric_Red
IC1: MAX-M10S-00B; MAXM10S00B; Manufacturer_Part_Number MAX-M10S-00B; Mouser Part Number 377-MAX-M10S-00B
J2: U.FL-R-SMT-1_10_; HRS_U.FL-R-SMT-1_10_
JP2: Jumper_2_NC_Trace
L2: 27nH LQG15HN27NH02D; L_0402_1005Metric
R7, R8, R9, R10, R11, R12, R13, R14: 33; R_0402_1005Metric
R18: 1k; R_0402_1005Metric
R19: 10; R_1210_3225Metric; MPN AC1210FR-7W10RL
TP1: 1.0mm; TestPoint-1.0mm

Connections:
3V3: C5.1, C6.1, C7.1, IC1.7 (V_IO), IC1.8 (VCC)
GND: C5.2, C6.2, C7.2, C15.2, C16.2, D2.2, IC1.1 (GND_1), IC1.10 (GND_2), IC1.12 (GND_3), JP2.1 (A)
GNSS_INT: R13.2
GNSS_RESET: R7.2
GNSS_SAFE: R12.1
unnamed: C16.1, L2.1, R19.1
unnamed: D2.1, IC1.11 (RF_IN), J2.2, L2.2
unnamed: D3.1 (K), JP2.2 (B)
unnamed: D3.2 (A), R18.1
unnamed: IC1.2 (TXD), R9.1
unnamed: IC1.3 (RXD), R8.1
unnamed: IC1.4 (TIMEPULSE), R14.1
unnamed: IC1.5 (EXTINT), R13.1
unnamed: IC1.9 (RESET_N), R7.1
unnamed: IC1.14 (VCC_RF), R19.2
unnamed: IC1.16 (SDA), R10.2
unnamed: IC1.17 (SCL), R11.2
unnamed: IC1.18 (SAFEBOOT_N), R12.2
unnamed: J2.1, J2.3
PPS: R14.2, R18.2, TP1.1
RXD: R8.2
SCL: R11.1
SDA: R10.1
TXD: R9.2
V_BACKUP: C15.1, IC1.6 (V_BCKP)
