MediBrick/IMU_Brick/v2/KiCAD/design_blocks/ActivityBrick.kicad_blocks/I2C Pullup.kicad_block/I2C Pullup.kicad_sch

## KiCad design v2/KiCAD/design_blocks/ActivityBrick.kicad_blocks/I2C Pullup.kicad_block/I2C Pullup.kicad_sch (2026-11-02)

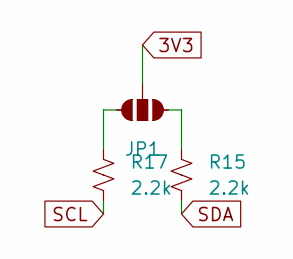
[picture p23: schematic I2C Pullup.kicad_sch]

Parts:
JP1: Jumper_3_NO
R15, R17: 2.2k; R_0402_1005Metric

Connections:
3V3: JP1.2 (B)
unnamed: JP1.1 (A), R15.1
unnamed: JP1.3 (C), R17.1
SCL: R17.2
SDA: R15.2
