MediBrick/IMU_Brick/v2/KiCAD/design_blocks/ActivityBrick.kicad_blocks/Mounting Holes.kicad_block/Mounting Holes.kicad_sch

## KiCad design v2/KiCAD/design_blocks/ActivityBrick.kicad_blocks/Mounting Holes.kicad_block/Mounting Holes.kicad_sch (2026-11-02)

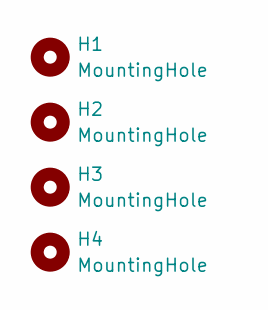
[picture p24: schematic Mounting Holes.kicad_sch]

Parts:
H1, H2, H3, H4: MountingHole; MountingHole_3.5mm
