MediBrick/IMU_Brick/v2/KiCAD/design_blocks/ActivityBrick.kicad_blocks/ON_LED.kicad_block/ON_LED.kicad_sch

## KiCad design v2/KiCAD/design_blocks/ActivityBrick.kicad_blocks/ON_LED.kicad_block/ON_LED.kicad_sch (2026-11-02)

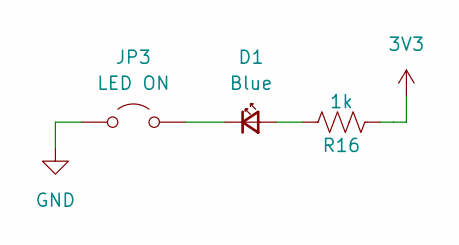
[picture p25: schematic ON_LED.kicad_sch]

Parts:
D1: Blue; LED_0402_1005Metric_Red
JP3: LED ON; Jumper_2_NO_NoSilk
R16: 1k; R_0402_1005Metric

Connections:
3V3: R16.2
GND: JP3.1 (A)
unnamed: D1.1 (K), JP3.2 (B)
unnamed: D1.2 (A), R16.1
