MediBrick/IMU_Brick/v2/KiCAD/design_blocks/ActivityBrick.kicad_blocks/Power.kicad_block/Power.kicad_sch

## KiCad design v2/KiCAD/design_blocks/ActivityBrick.kicad_blocks/Power.kicad_block/Power.kicad_sch (2026-11-02)

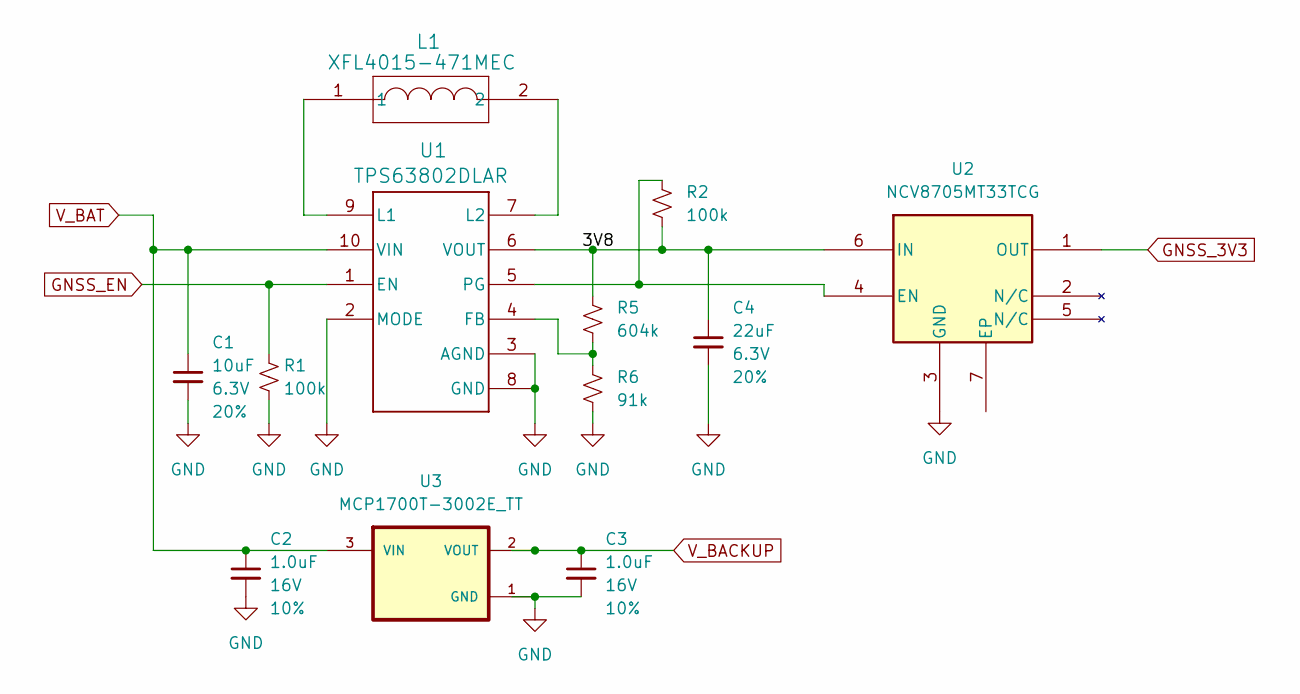
[picture p26: schematic Power.kicad_sch]

Parts:
C1: 10uF; C_0402_1005Metric; Voltage 6.3V; Tolerance 20%
C2, C3: 1.0uF; C_0402_1005Metric; Voltage 16V; Tolerance 10%
C4: 22uF; C_0603_1608Metric; Voltage 6.3V; Tolerance 20%
L1: XFL4015-471MEC; IND_XFL4015_COC
R1, R2: 100k; R_0402_1005Metric
R5: 604k; R_0603_1608Metric
R6: 91k; R_0603_1608Metric
U1: TPS63802DLAR; DLA0010A
U2: NCV8705MT33TCG; WDFN6_2X2_ONS_NCV8705
U3: MCP1700T-3002E_TT; SOT95P237X112-3N_MCP1700

Connections:
3V8: C4.1, R2.2, R5.2, U1.6 (VOUT), U2.6 (IN)
GND: C1.2, C2.2, C3.2, C4.2, R1.2, R6.1, U1.2 (MODE), U1.3 (AGND), U1.8 (GND), U2.3 (GND), U3.1 (GND)
GNSS_3V3: U2.1 (OUT)
GNSS_EN: R1.1, U1.1 (EN)
unnamed: L1.1, U1.9 (L1)
unnamed: L1.2, U1.7 (L2)
unnamed: R2.1, U1.5 (PG), U2.4 (EN)
unnamed: R5.1, R6.2, U1.4 (FB)
V_BACKUP: C3.1, U3.2 (VOUT)
V_BAT: C1.1, C2.1, U1.10 (VIN), U3.3 (VIN)
