MediBrick/IMU_Brick/v2/KiCAD/design_blocks/ActivityBrick.kicad_blocks/Sensors.kicad_block/Sensors.kicad_sch

## KiCad design v2/KiCAD/design_blocks/ActivityBrick.kicad_blocks/Sensors.kicad_block/Sensors.kicad_sch (2026-11-02)

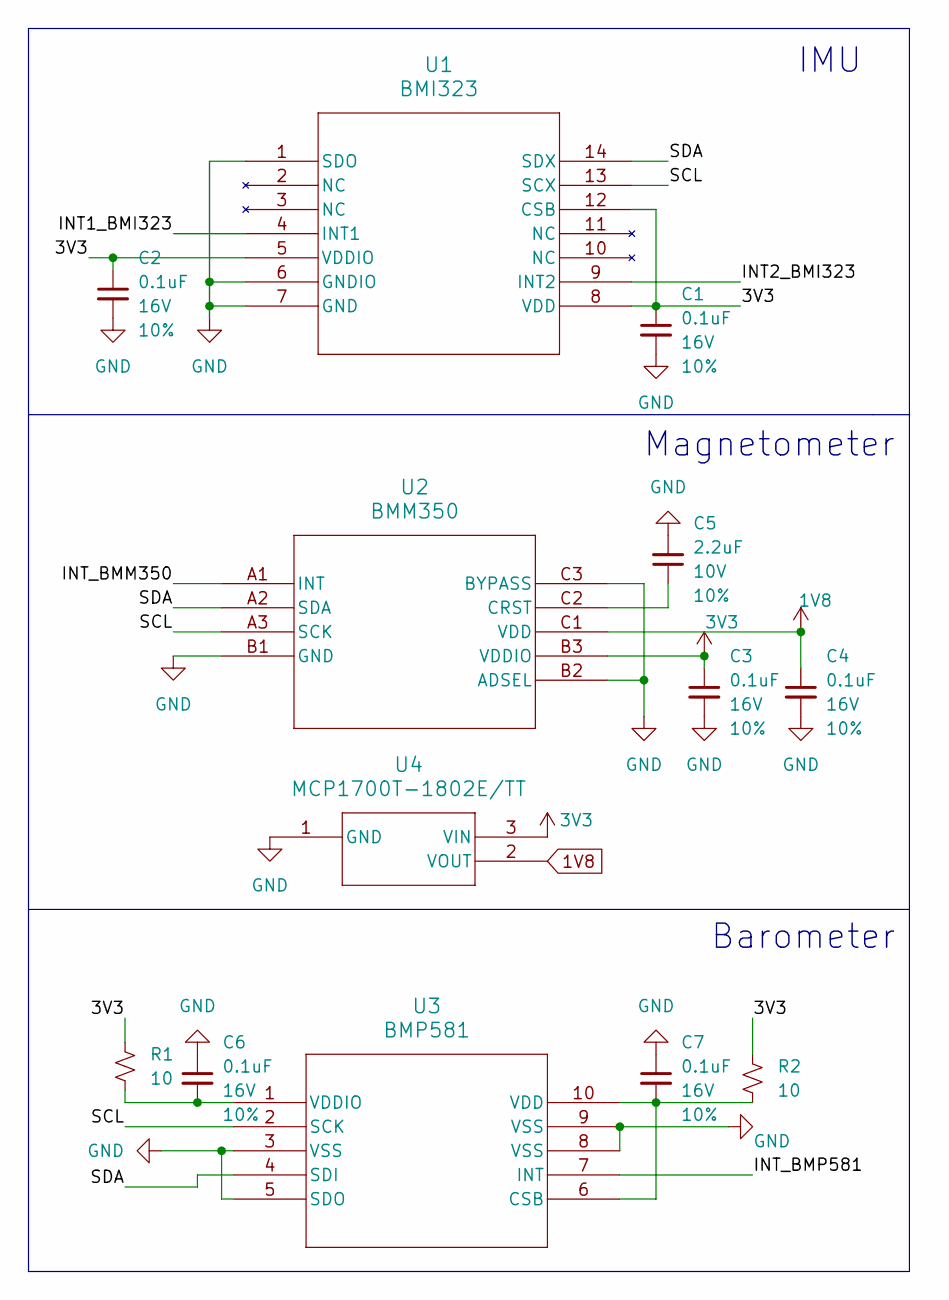
[picture p27: schematic Sensors.kicad_sch]

Parts:
C1, C2, C3, C4, C6, C7: 0.1uF; C_0402_1005Metric; Voltage 16V; Tolerance 10%
C5: 2.2uF; C_0402_1005Metric; Voltage 10V; Tolerance 10%
R1, R2: 10; R_0402_1005Metric
U1: BMI323; BMI323_BOS
U2: BMM350; BGA9_BMM350_BOS
U3: BMP581; QFN10_BMP581_BOS
U4: MCP1700T-1802E/TT; SOT-23_MC_MCH

Connections:
1V8: C4.1, U2.C1 (VDD), U4.2 (VOUT)
3V3: C1.1, C2.1, C3.1, R1.2, R2.2, U1.5 (VDDIO), U1.8 (VDD), U1.12 (CSB), U2.B3 (VDDIO), U4.3 (VIN)
GND: C1.2, C2.2, C3.2, C4.2, C5.2, C6.1, C7.1, U1.1 (SDO), U1.6 (GNDIO), U1.7 (GND), U2.B1 (GND), U2.B2 (ADSEL), U2.C3 (BYPASS), U3.3 (VSS), U3.5 (SDO), U3.8 (VSS), U3.9 (VSS), U4.1 (GND)
INT1_BMI323: U1.4 (INT1)
INT2_BMI323: U1.9 (INT2)
INT_BMM350: U2.A1 (INT)
INT_BMP581: U3.7 (INT)
unnamed: C5.1, U2.C2 (CRST)
unnamed: C6.2, R1.1, U3.1 (VDDIO)
unnamed: C7.2, R2.1, U3.6 (CSB), U3.10 (VDD)
SCL: U1.13 (SCX), U2.A3 (SCK), U3.2 (SCK)
SDA: U1.14 (SDX), U2.A2 (SDA), U3.4 (SDI)

Notes on the sheet:
Barometer
Magnetometer
IMU
