MediBrick/IMU_Brick/(commit log)

2025-12-08 Add initial README for IMU_Brick project
2026-11-02 Preserve v1 IMU design and add Activity Brick v2 hardware
    [ActivityBrickV2.kicad_pcb, ActivityBrickV2.kicad_sch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]
