MediBrick/IMU_Brick/(notices)

Notices in the files:
parts and their libraries:
SparkFun-Jumpers: Licensing: Creative Commons ShareAlike 4.0 International - https://creativecommons.org/licenses/by-sa/4.0
SparkFun-LED: Licensing: CC v3.0 Share-Alike You are welcome to use this library for commercial purposes.
SparkFun-Aesthetics: https://creativecommons.org/licenses/by-sa/4.0
